liyakeselman/Spinning_Top_Real_Time_Platform/OtherFolders/MediaFiles/Images/Wallpapers/w3.png

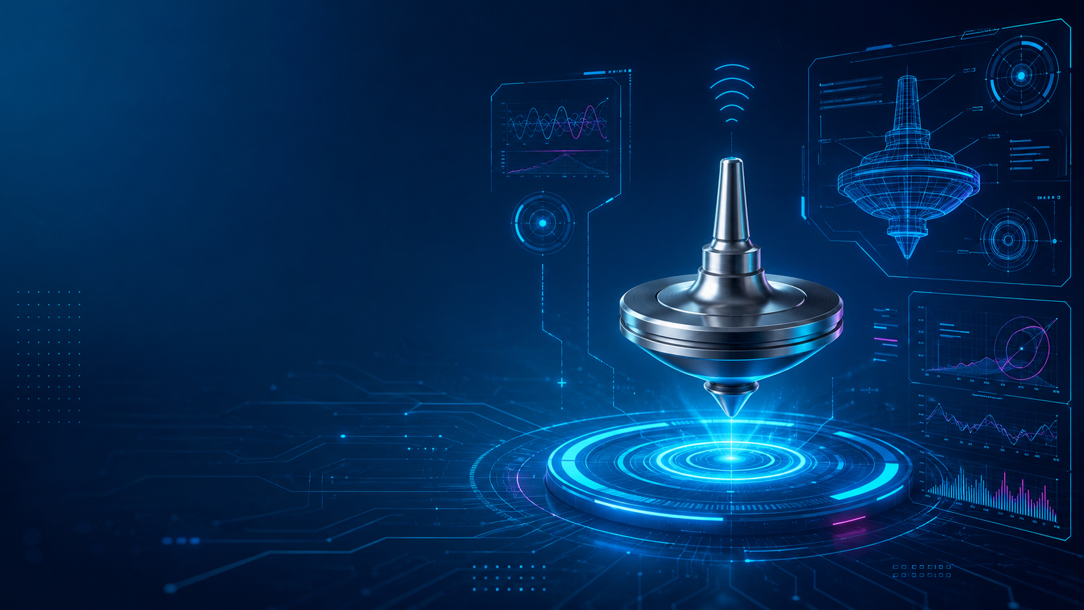
OtherFolders/MediaFiles/Images/Wallpapers/w3.png
