liyakeselman/Spinning_Top_Real_Time_Platform/OtherFolders/MediaFiles/Images/Wallpapers/w1.png

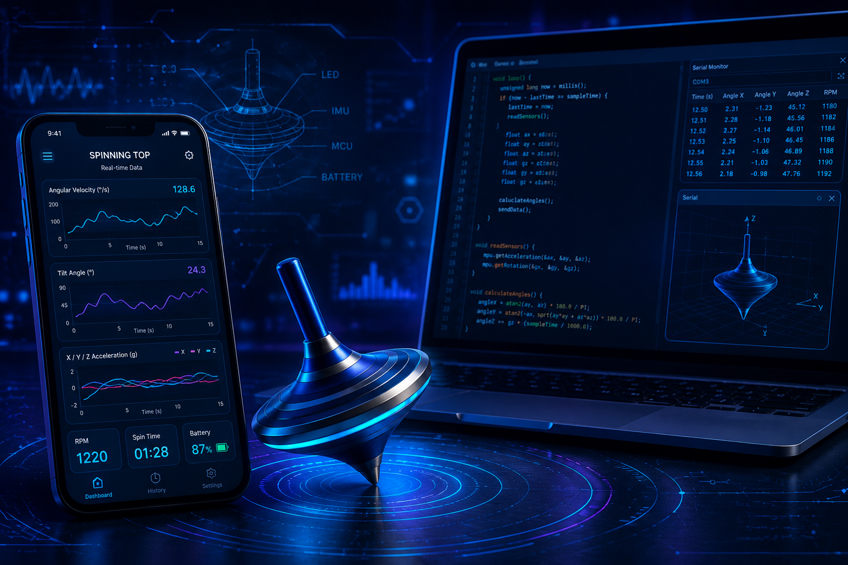
OtherFolders/MediaFiles/Images/Wallpapers/w1.png
