liyakeselman/Spinning_Top_Real_Time_Platform/Data_sh/Readme.txt

Data_sh Directory Content:
(directory) Battery
(directory) Distance_Sensors
(directory) ESP32
(directory) Light_Dependant_Resistor
(directory) Motor_Driver_L9110S
(directory) MPU6050
