liyakeselman/Spinning_Top_Real_Time_Platform/OtherFolders/Readme.txt

OtherFolders Directory Content:
(directory) MediaFiles
(directory) KiCad
(directory) ErrorSheet
(directory) ComponentsList
(directory) BOM
(directory) 3D_PrintFiles
(directory) 3D_Fusion360Files
