liyakeselman/Spinning_Top_Real_Time_Platform/Sch/Readme.txt

Sch Directory Content:
CompositionScheme.pdf
Schematic.pdf
