liyakeselman/Spinning_Top_Real_Time_Platform/OtherFolders/KiCad/Readme.txt

KiCad Directory Content:
(directory) KiCad_ProjA
(directory) KiCad_ProjB
