liyakeselman/Spinning_Top_Real_Time_Platform/OtherFolders/3D_Fusion360Files/ProjectA_3D_Fusion360Files/Readme.txt

ProjectA_3D_Fusion360Files Directory Content:
(directory) BatteryFiles 
(directory) BatteryHolderFiles
(directory) BuckBoostConverterFiles
(directory) DreidelFiles
(directory) ESP32Files
(directory) GeometryFiles
(directory) HammerFiles
(directory) FullModelFiles
(directory) MotorDriverFiles
(directory) MPU6050Files
(directory) ScrewsFiles
(directory) TFLunaFiles
(directory) TP4056Files
(directory) TubeWeightFiles
(directory) VL53L0XV2Files
