liyakeselman/Spinning_Top_Real_Time_Platform/OtherFolders/KiCad/KiCad_ProjA/projectA/production/invoice.pdf

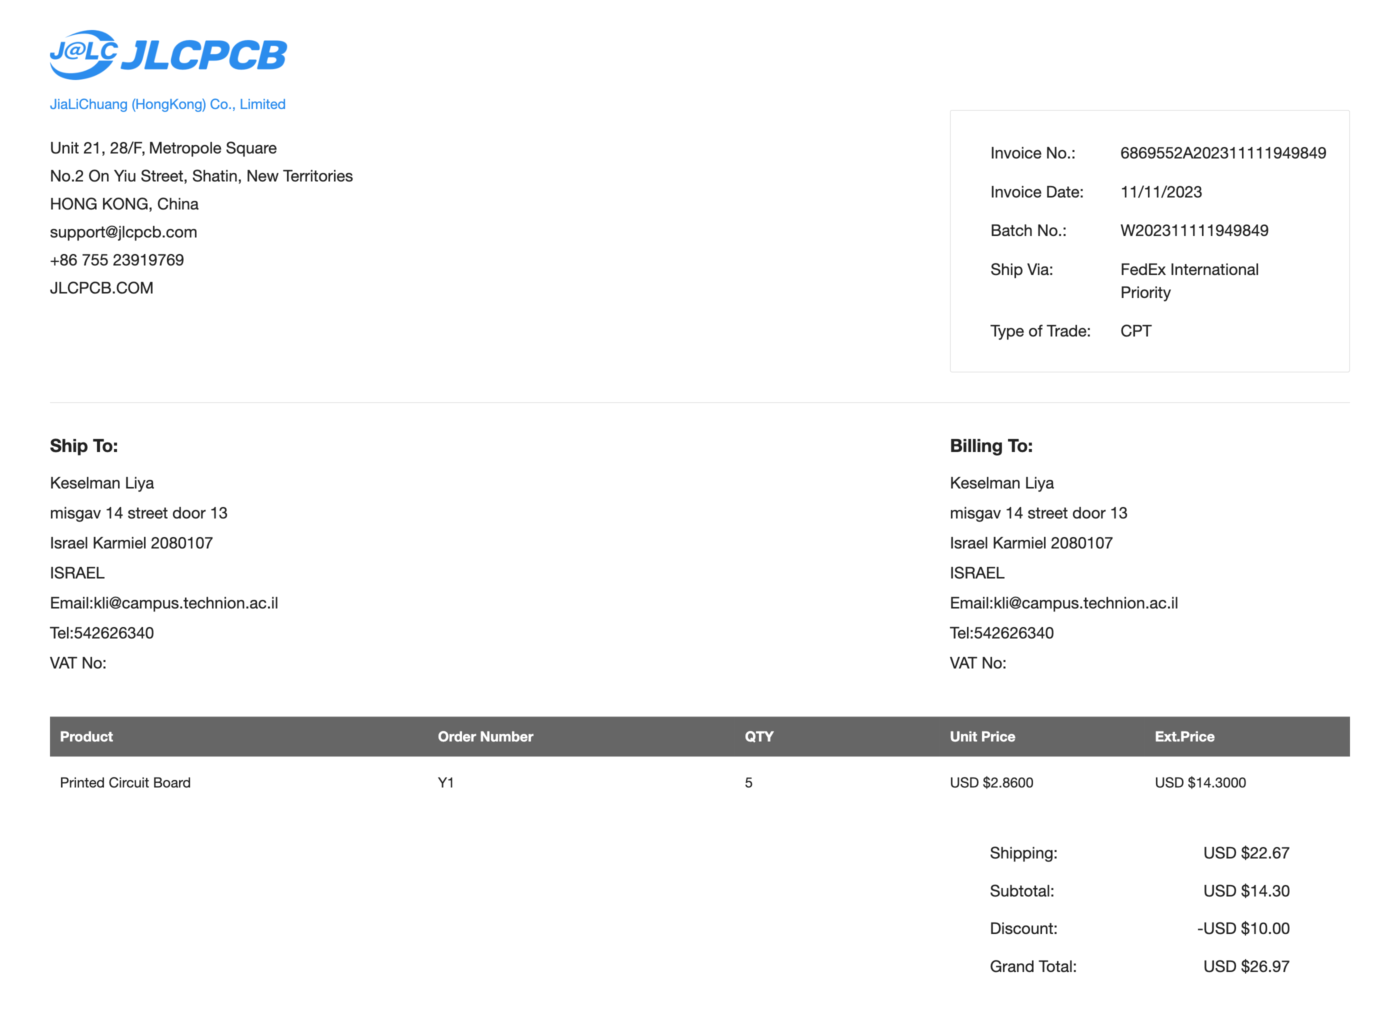
[picture p37: figure]
