liyakeselman/Spinning_Top_Real_Time_Platform/OtherFolders/KiCad/KiCad_ProjA/projectA/production/salesContract.pdf

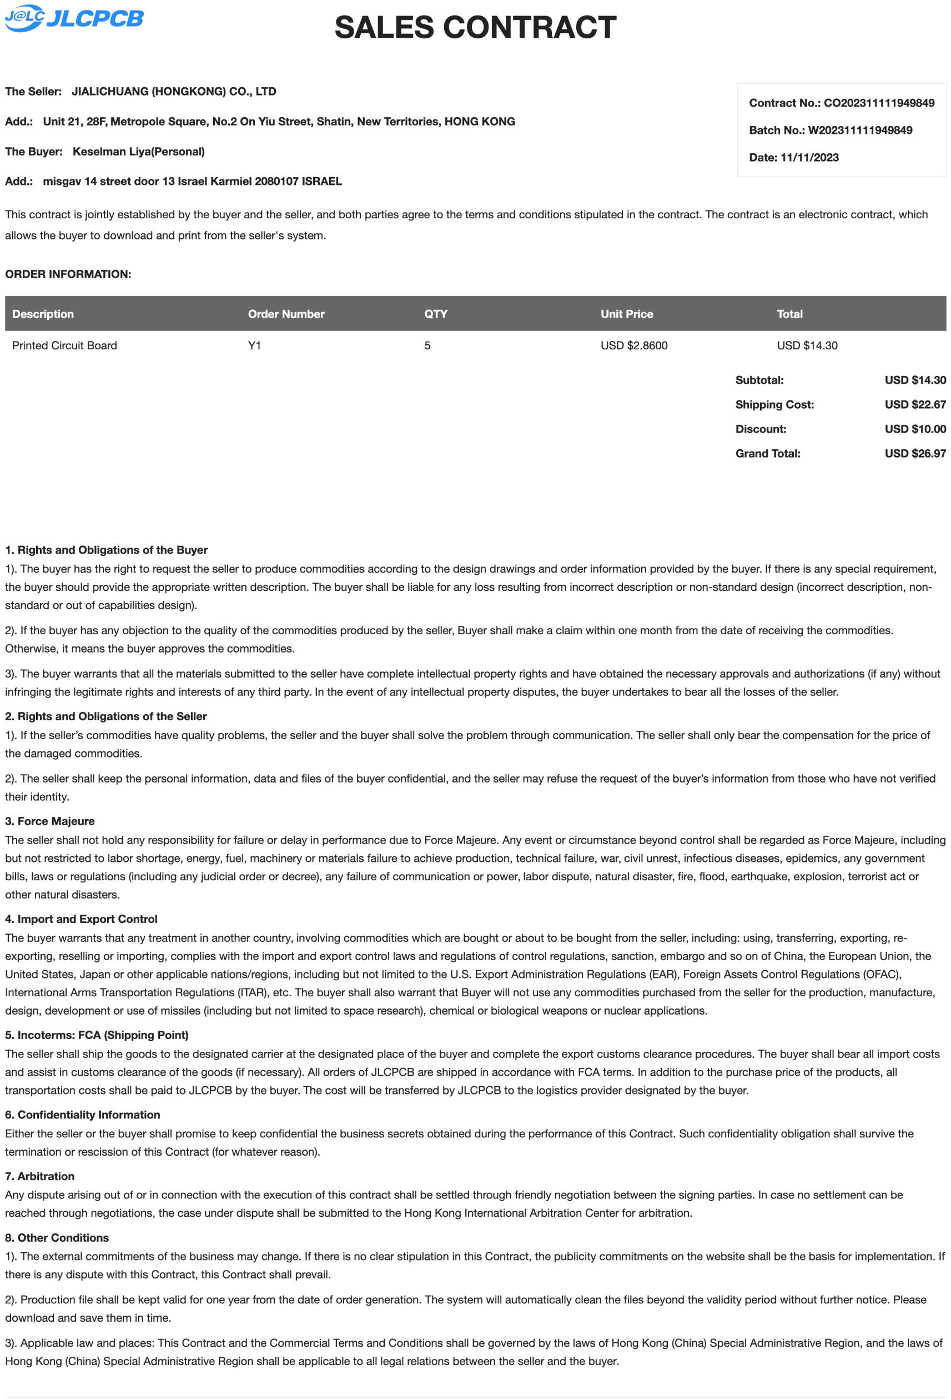
[picture p38: page 1]
