liyakeselman/Spinning_Top_Real_Time_Platform/OtherFolders/3D_Fusion360Files/ProjectA_3D_Fusion360Files/BatteryHolderFiles/lithium-ion-18650-battery-holder-1.snapshot.3/Battery Holder.PNG

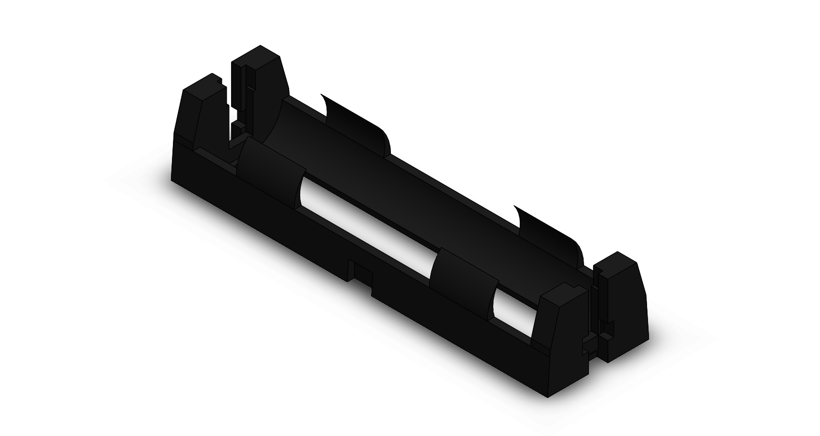
OtherFolders/3D_Fusion360Files/ProjectA_3D_Fusion360Files/BatteryHolderFiles/lithium-ion-18650-battery-holder-1.snapshot.3/Battery Holder.PNG
