liyakeselman/Spinning_Top_Real_Time_Platform/OtherFolders/3D_Fusion360Files/ProjectA_3D_Fusion360Files/BuckBoostConverterFiles/buck_boost.png

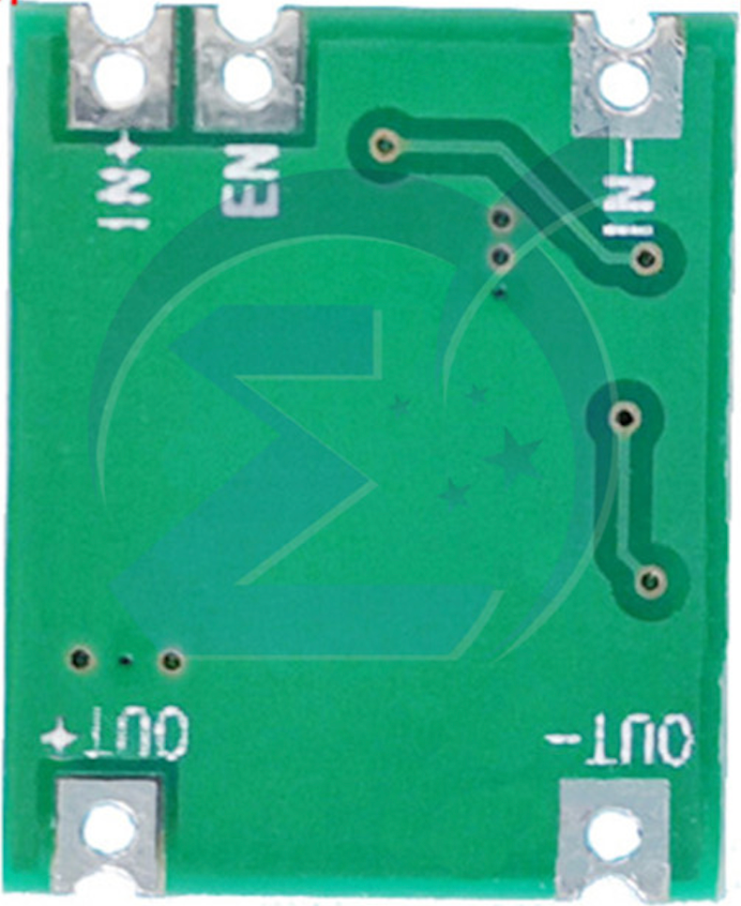
OtherFolders/3D_Fusion360Files/ProjectA_3D_Fusion360Files/BuckBoostConverterFiles/buck_boost.png
