liyakeselman/Spinning_Top_Real_Time_Platform/OtherFolders/3D_Fusion360Files/ProjectA_3D_Fusion360Files/BuckBoostConverterFiles/DC3V-15V-Buck-Boost.jpg_.webp

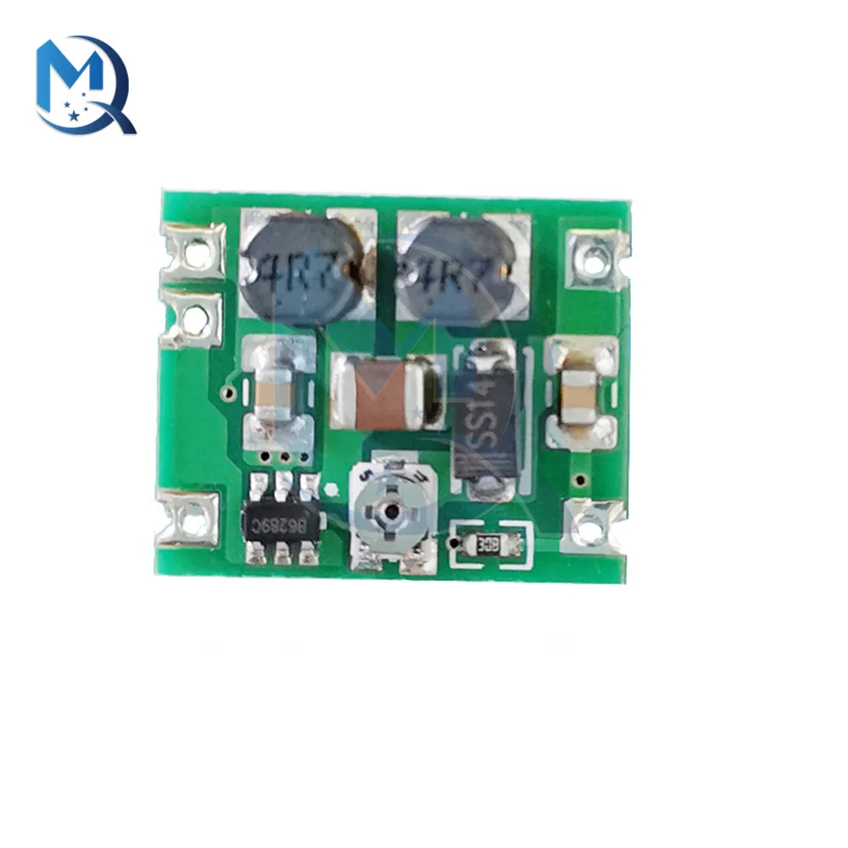
OtherFolders/3D_Fusion360Files/ProjectA_3D_Fusion360Files/BuckBoostConverterFiles/DC3V-15V-Buck-Boost.jpg_.webp
