liyakeselman/Spinning_Top_Real_Time_Platform/OtherFolders/3D_Fusion360Files/ProjectA_3D_Fusion360Files/ESP32Files/option2_goouuu-esp32-development-board-1.snapshot.3/Goouuu-ESP32 Development Board - ISO.JPG

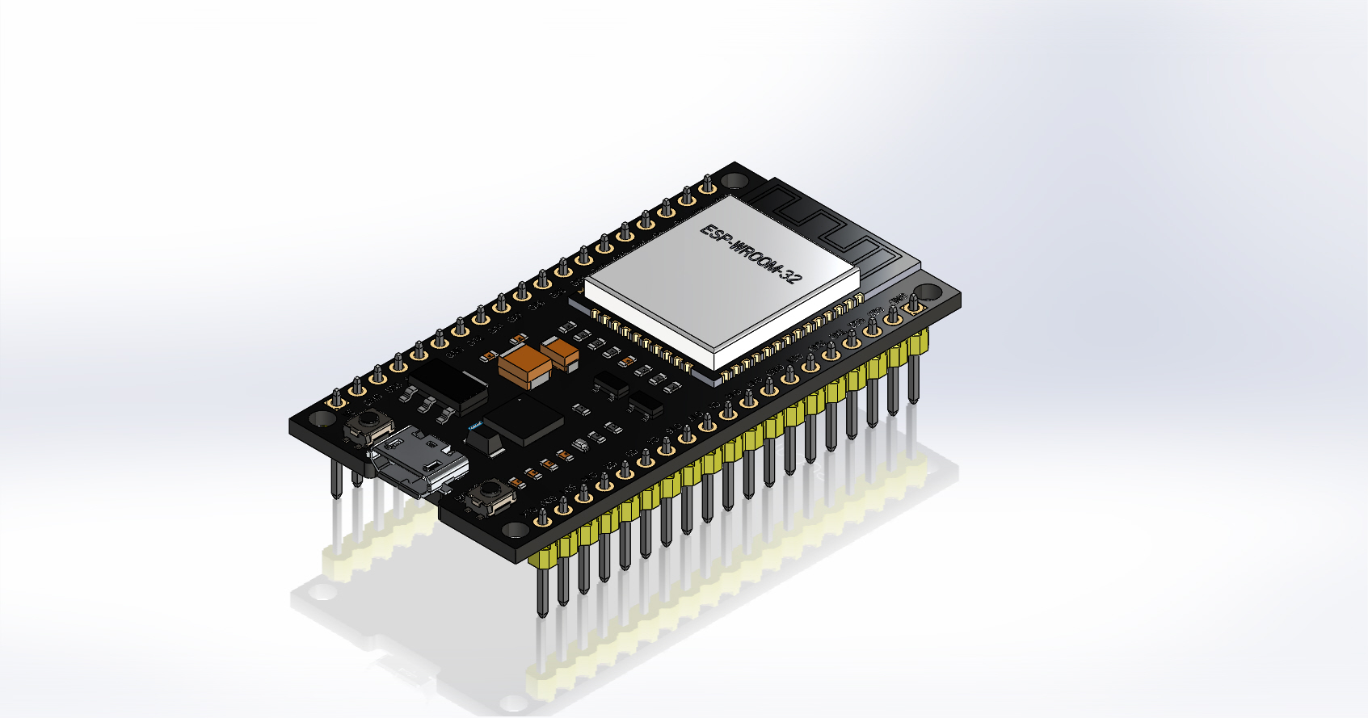
OtherFolders/3D_Fusion360Files/ProjectA_3D_Fusion360Files/ESP32Files/option2_goouuu-esp32-development-board-1.snapshot.3/Goouuu-ESP32 Development Board - ISO.JPG
