liyakeselman/Spinning_Top_Real_Time_Platform/OtherFolders/3D_Fusion360Files/ProjectA_3D_Fusion360Files/TP4056Files/tp4056_option1/微信图片_20210121220738.jpg

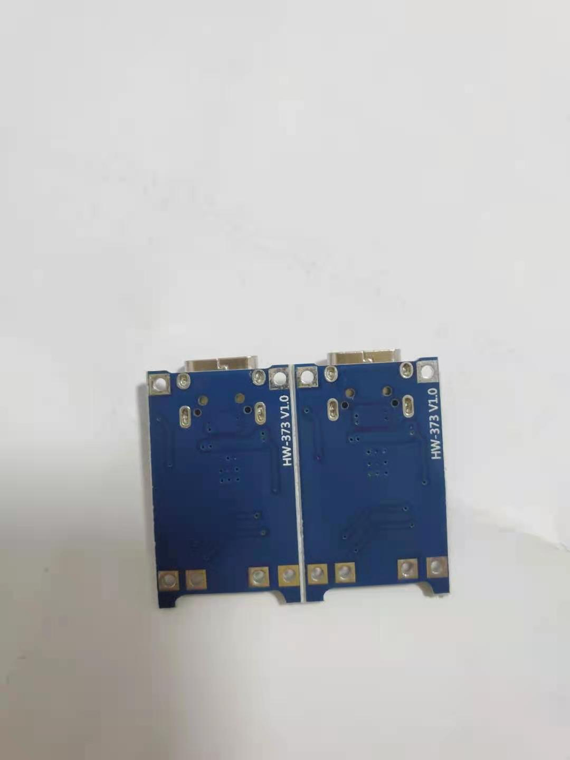
OtherFolders/3D_Fusion360Files/ProjectA_3D_Fusion360Files/TP4056Files/tp4056_option1/微信图片_20210121220738.jpg
