liyakeselman/Spinning_Top_Real_Time_Platform/OtherFolders/MediaFiles/Images/3DModel/3D_1.png

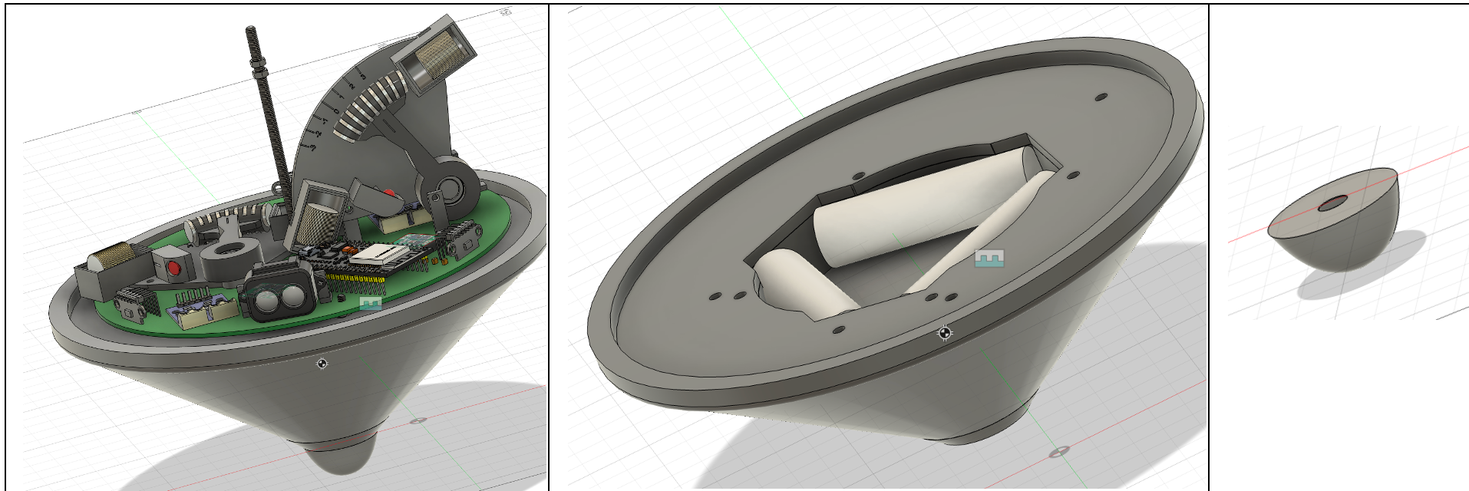
OtherFolders/MediaFiles/Images/3DModel/3D_1.png
