liyakeselman/Spinning_Top_Real_Time_Platform/OtherFolders/MediaFiles/Images/CAM/3dprint.png

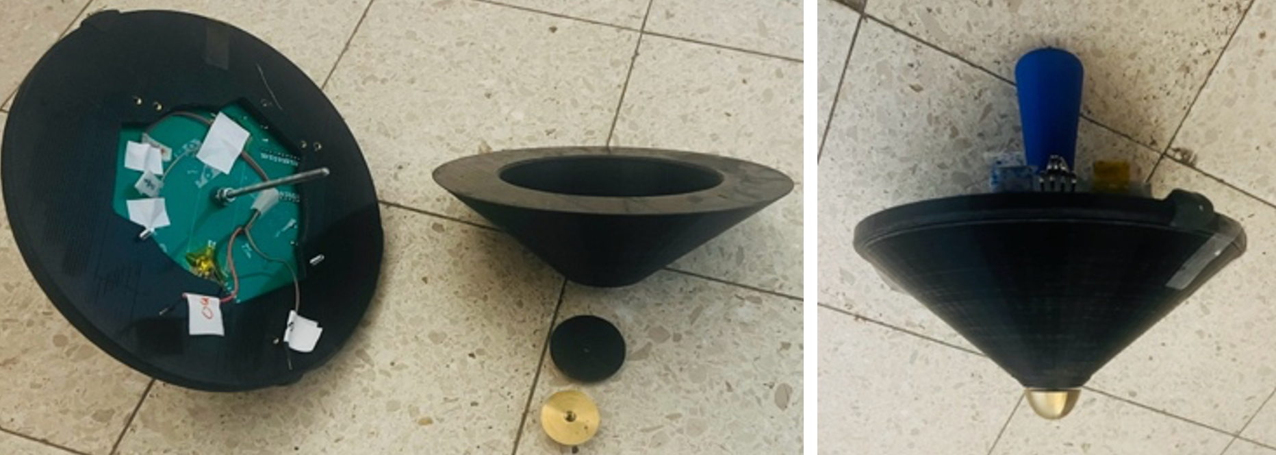
OtherFolders/MediaFiles/Images/CAM/3dprint.png
