liyakeselman/Spinning_Top_Real_Time_Platform/OtherFolders/MediaFiles/Images/CAM/app.png

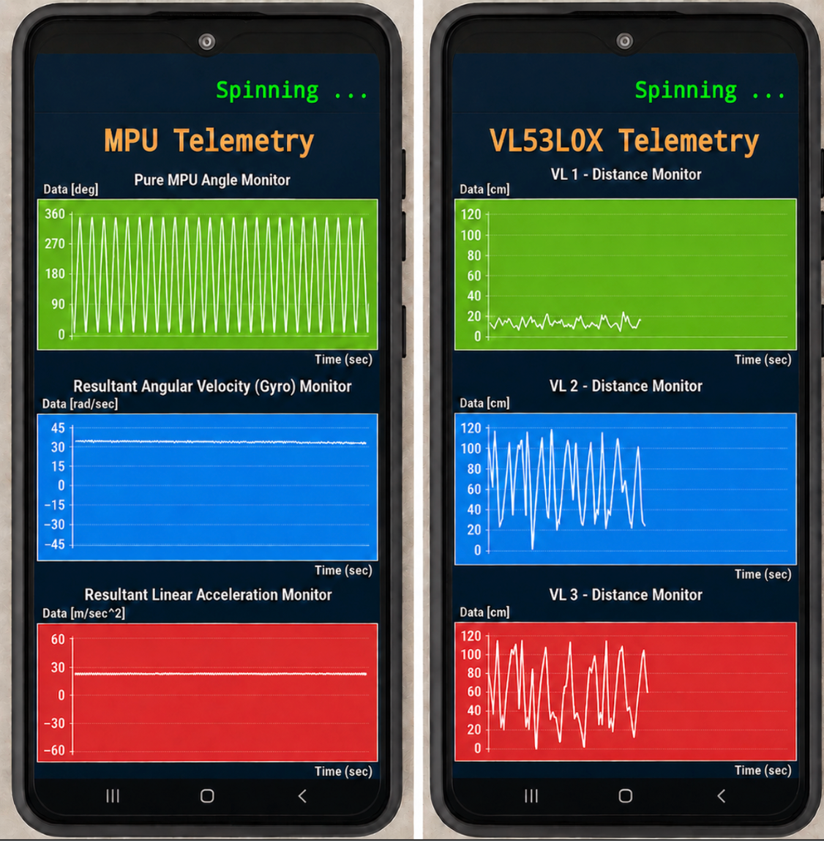
OtherFolders/MediaFiles/Images/CAM/app.png
