liyakeselman/Spinning_Top_Real_Time_Platform/OtherFolders/MediaFiles/Images/CAM/pcb.png

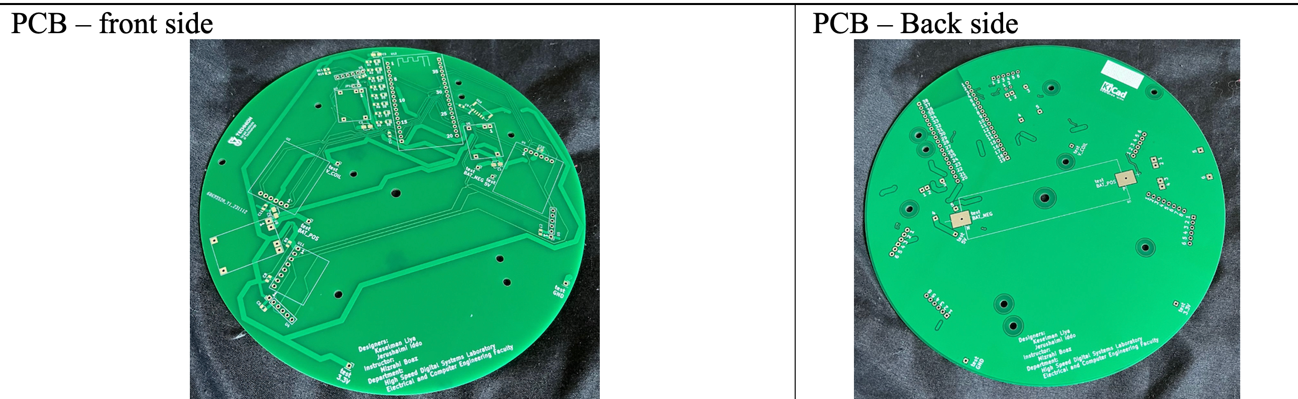
OtherFolders/MediaFiles/Images/CAM/pcb.png
