liyakeselman/Spinning_Top_Real_Time_Platform/OtherFolders/MediaFiles/Images/CAM/spinningtop1.png

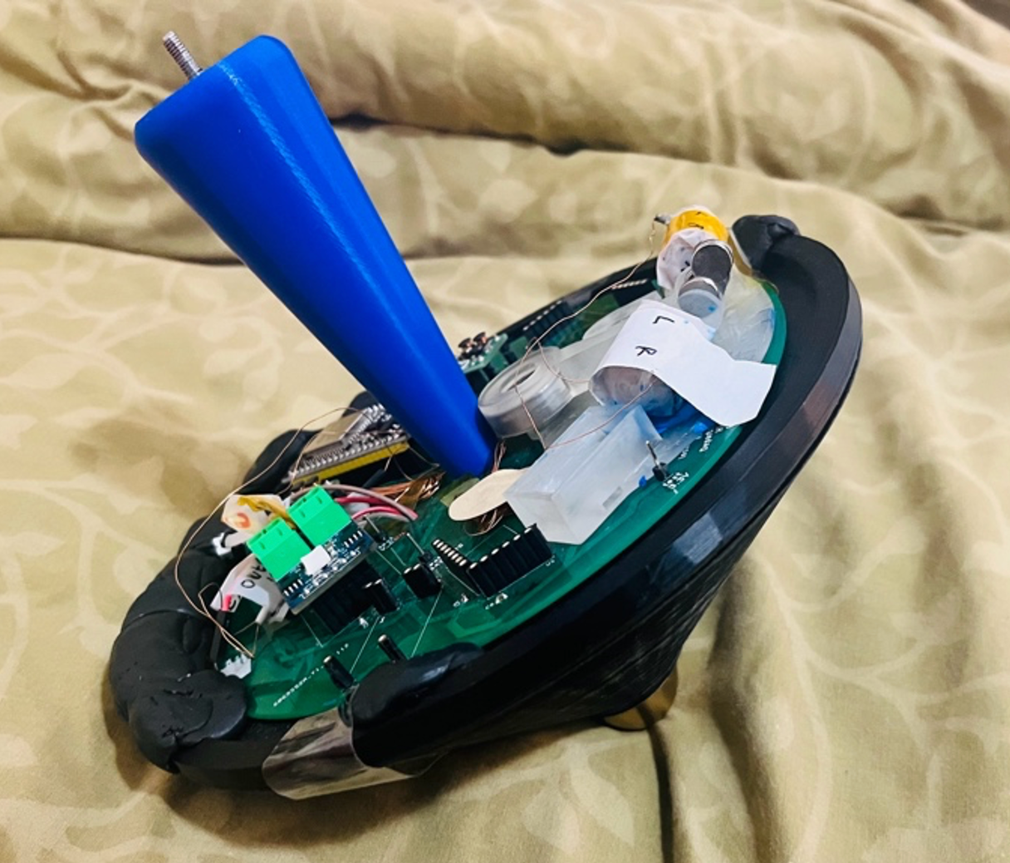
OtherFolders/MediaFiles/Images/CAM/spinningtop1.png
