liyakeselman/Spinning_Top_Real_Time_Platform/OtherFolders/MediaFiles/Images/CAM/spinningtop2.png

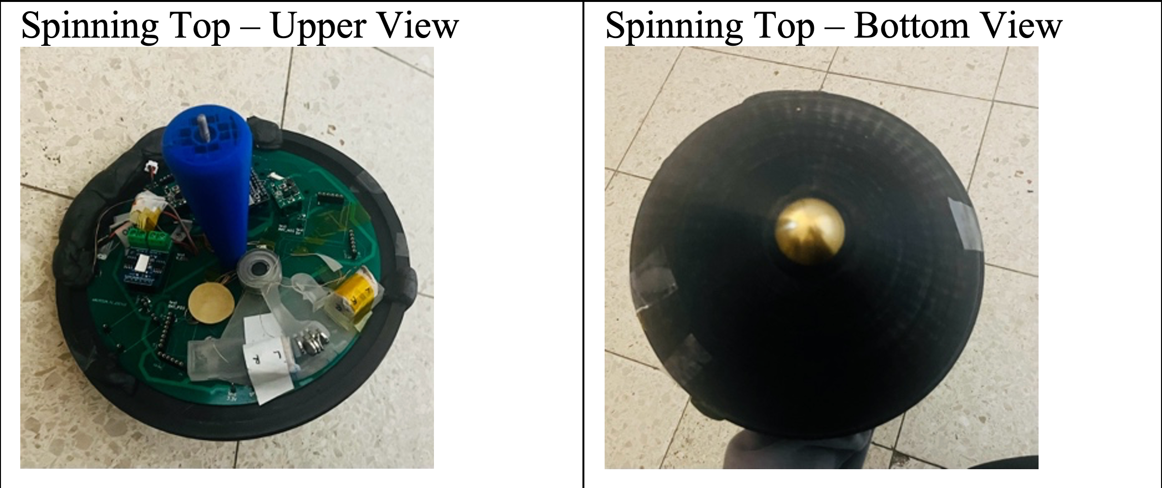
OtherFolders/MediaFiles/Images/CAM/spinningtop2.png
