liyakeselman/Spinning_Top_Real_Time_Platform/OtherFolders/MediaFiles/Images/CAM/spinningtop3.png

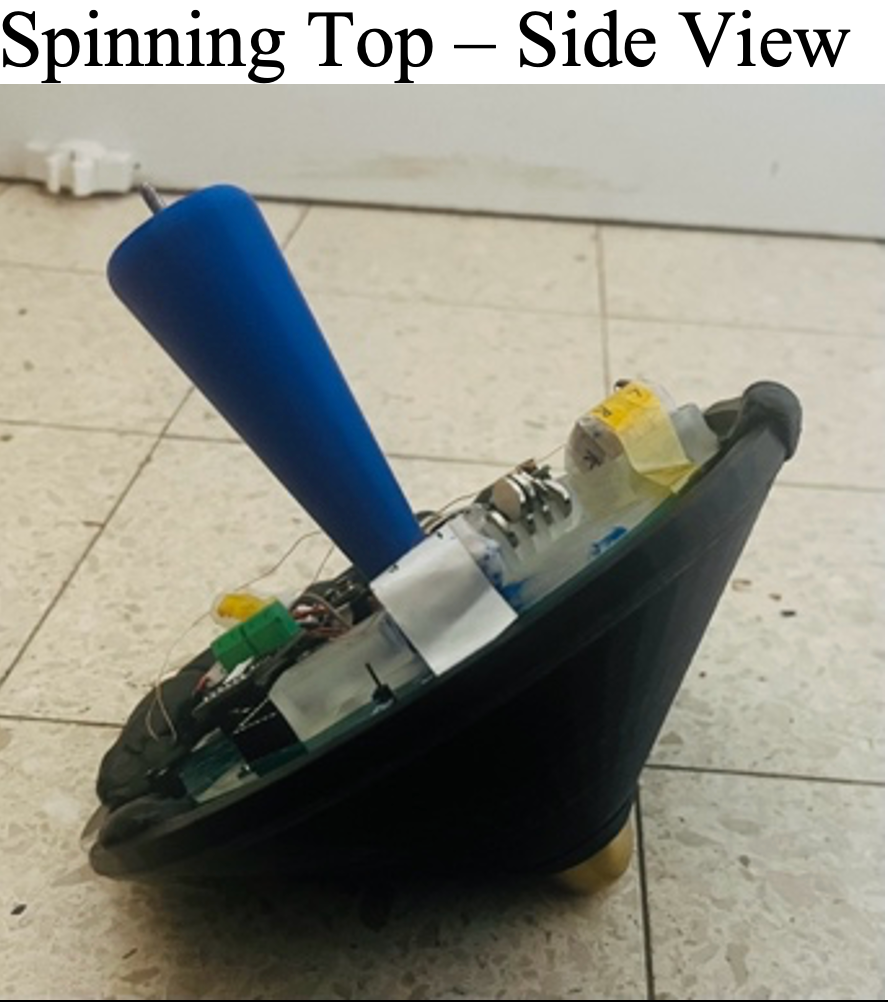
OtherFolders/MediaFiles/Images/CAM/spinningtop3.png
