liyakeselman/Spinning_Top_Real_Time_Platform/OtherFolders/MediaFiles/Images/CAM/stabilization.png

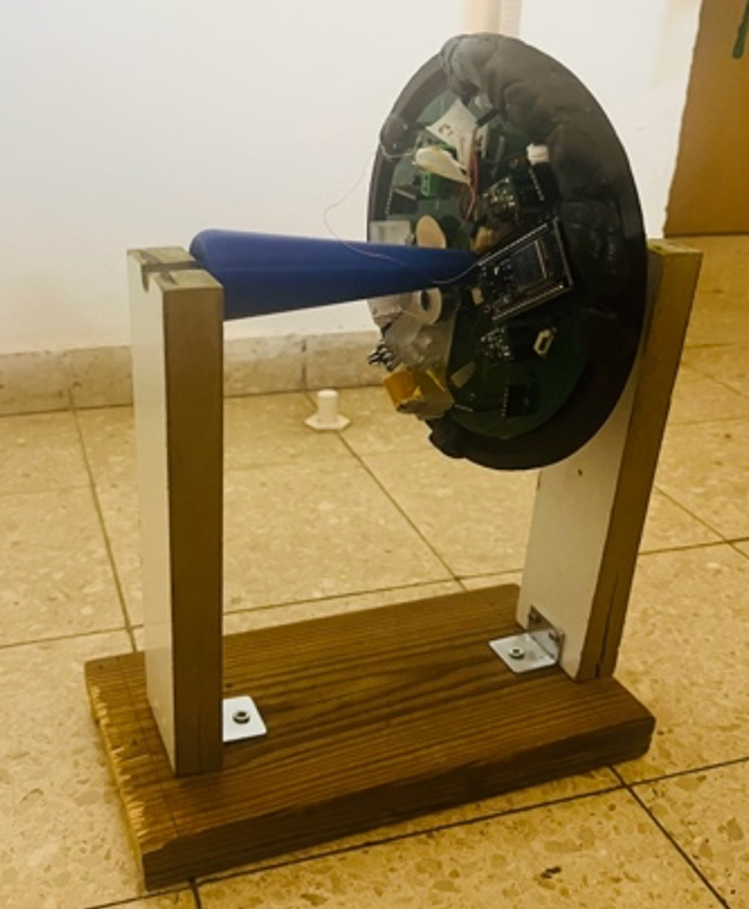
OtherFolders/MediaFiles/Images/CAM/stabilization.png
