liyakeselman/Spinning_Top_Real_Time_Platform/OtherFolders/MediaFiles/Images/diagrams/diagram6.png

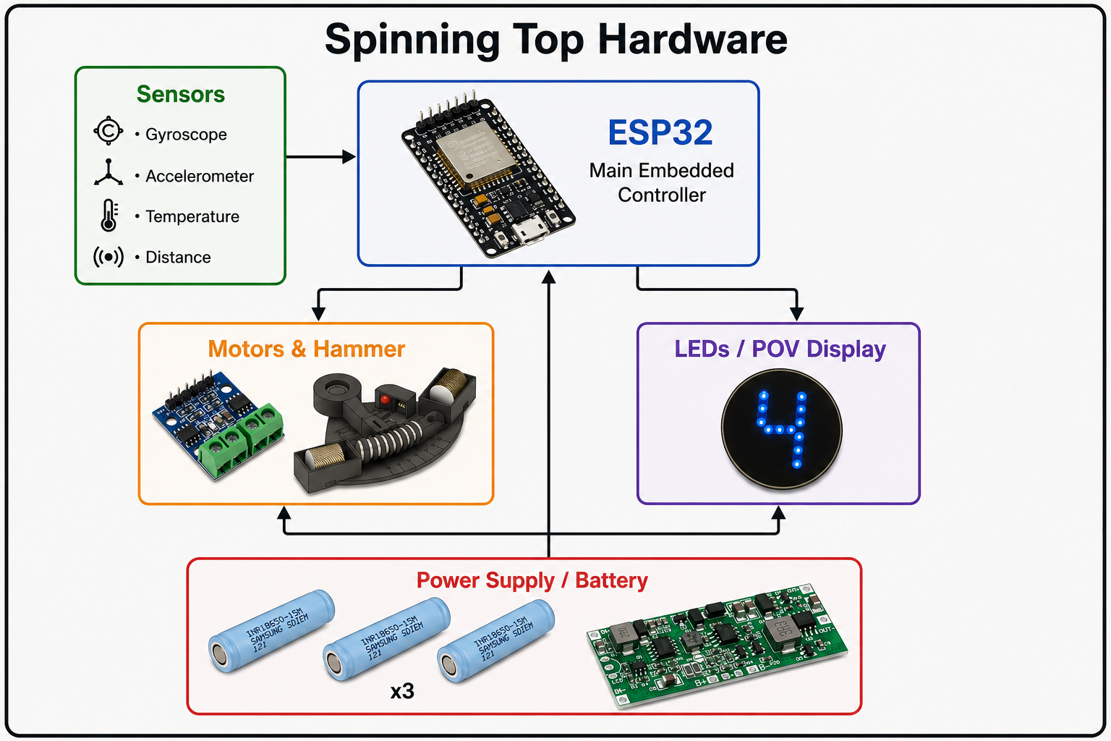
OtherFolders/MediaFiles/Images/diagrams/diagram6.png
