liyakeselman/Spinning_Top_Real_Time_Platform/OtherFolders/MediaFiles/Images/diagrams/diagram10.png

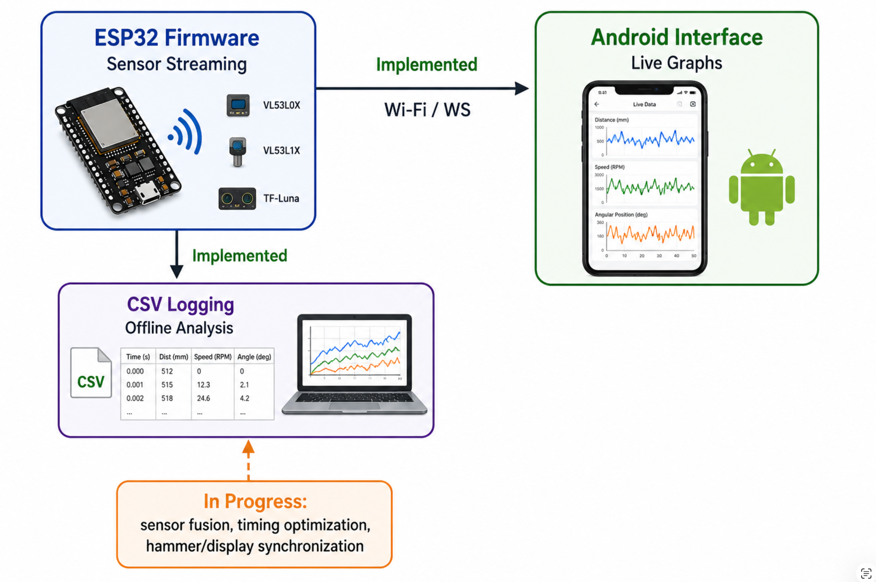
OtherFolders/MediaFiles/Images/diagrams/diagram10.png
