liyakeselman/Spinning_Top_Real_Time_Platform/OtherFolders/MediaFiles/Images/diagrams/diagram13.png

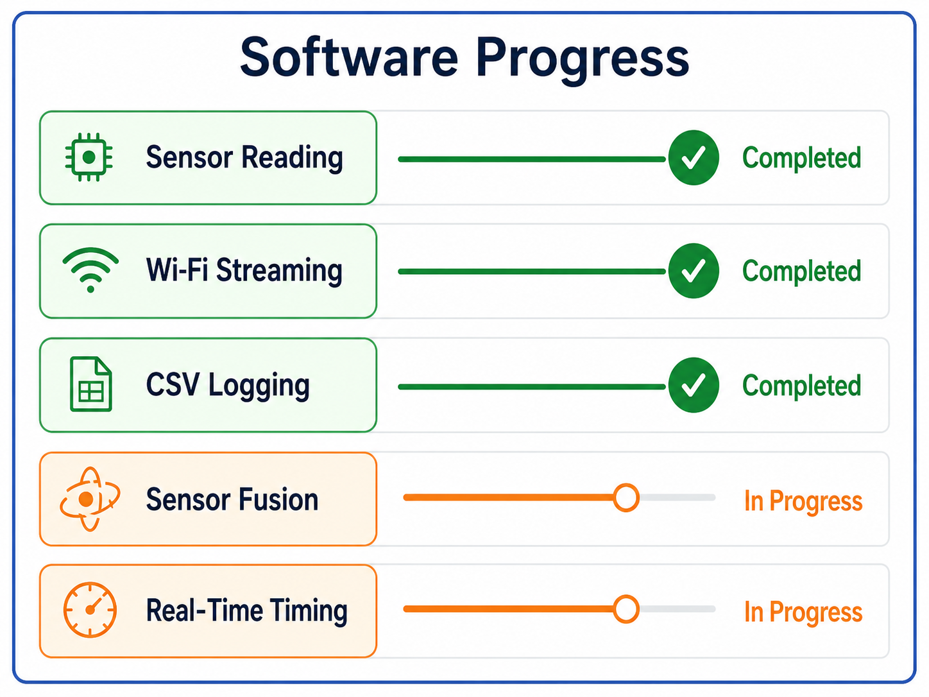
OtherFolders/MediaFiles/Images/diagrams/diagram13.png
