liyakeselman/Spinning_Top_Real_Time_Platform/OtherFolders/MediaFiles/Images/diagrams/diagram23png.png

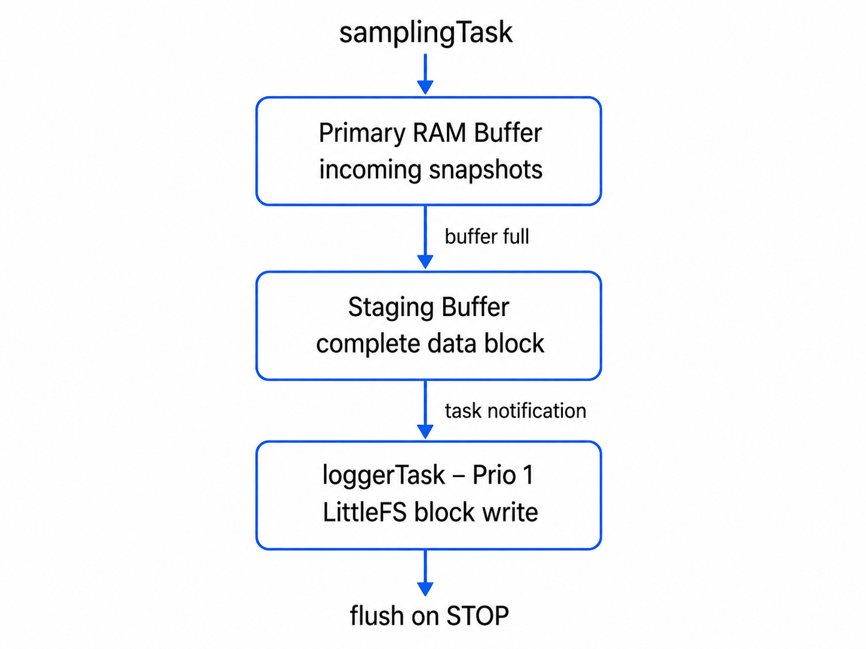
OtherFolders/MediaFiles/Images/diagrams/diagram23png.png
