liyakeselman/Spinning_Top_Real_Time_Platform/OtherFolders/MediaFiles/Images/Wallpapers/w2.png

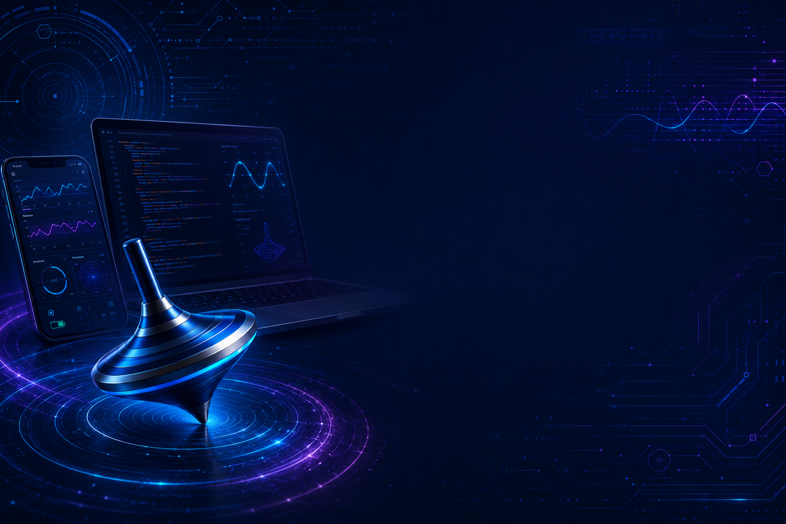
OtherFolders/MediaFiles/Images/Wallpapers/w2.png
