liyakeselman/Spinning_Top_Real_Time_Platform/OtherFolders/MediaFiles/Images/Wallpapers/w4.png

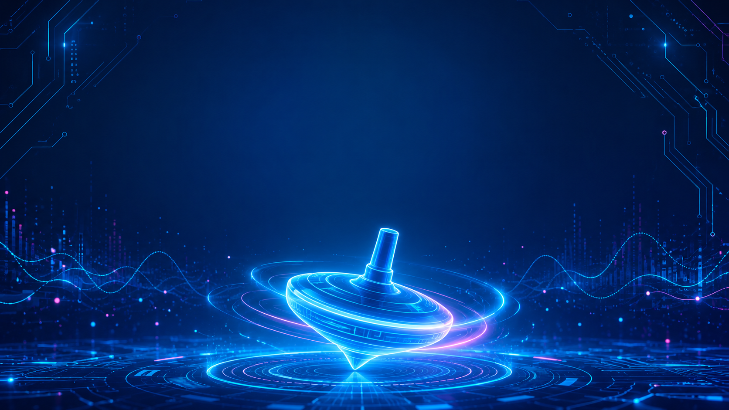
OtherFolders/MediaFiles/Images/Wallpapers/w4.png
