liyakeselman/Spinning_Top_Real_Time_Platform/OtherFolders/ComponentsList/components_list.pdf

טקיורפל םיביכר ב ודיעו היל לש ׳
| | ל רושיק -datasheet היינקל רושיק ביכר םש | תשרדנ תומכ ל2- וביבס םינ | ל רושיק -pinout לודומה לש
vl53l0xv2 distance sensor | link (https://he.aliexpress.com/item/32902676861.html?curPageLogUid=rx7kO7K3YIRo) | link (https://www.st.com/resource/en/datasheet/vl53l0x.pdf) | 6 | link (https://m.media-amazon.com/images/I/71omjIzckuL._SL1500_.jpg)
L9110 S- Channel Motor Driver | link (https://he.aliexpress.com/item/1005005469263941.html?curPageLogUid=7hnDj1nQTp9B) | link (https://www.laskakit.cz/user/related_files/l9110_2_channel_motor_driver.pdf) | 4 | link (https://he.aliexpress.com/item/4000640719200.html?curPageLogUid=mOxAnfovqIoe) link (https://www.utmel.com/components/l9110s-2-channel-motor-driver-circuit-pinout-and-how-to-work-video-faq?id=1988)
DC3V-15V Mini Automatic Buck-Boost Regulator Module Stabilized Power Supply Module DC-DC Automatic Voltage Regulator Board | link (https://he.aliexpress.com/item/1005009401493195.html?curPageLogUid=AawMpAeaVnFY) | aliexpress (https://www.aliexpress.com/item/1005003223925809.html?_t=pvid%3A15417089-c774-4343-b987-dd72966b16d5) | 4 | aliexpress (https://www.aliexpress.com/item/1005003223925809.html?_t=pvid%3A15417089-c774-4343-b987-dd72966b16d5)
1Set IIC I2C GY-521 MPU-6050 MPU6050 3 Axis Analog Gyroscope Sensors + Accelerometer Module For Arduino With Pins 3-5V DC | link (https://he.aliexpress.com/item/1005008604349573.html?curPageLogUid=zbkrNPWYP7Ae) | link (https://invensense.tdk.com/wp-content/uploads/2015/02/MPU-6000-Datasheet1.pdf) | 2 | link (https://components101.com/sensors/mpu6050-module)
Goouuu-ESP32 Development Board WiFi+Bluetooth Ultra-Low Power Consumption Dual Cores ESP-32 ESP-32S Board for arduino | link (https://he.aliexpress.com/item/1005010243973125.html?curPageLogUid=Hic9dPfUTtZG) | module_link (https://www.espressif.com/sites/default/files/documentation/esp32-wroom-32d_esp32-wroom-32u_datasheet_en.pdf) | 2 | link (https://www.upesy.com/blogs/tutorials/esp32-pinout-reference-gpio-pins-ultimate-guide)
Tf luna distance sensor | link (https://www.aliexpress.com/item/1005001552425264.html?curPageLogUid=FELvBh8KFW2E) | link (https://files.seeedstudio.com/wiki/Grove-TF_Mini_LiDAR/res/SJ-PM-TF-Luna-A03-Product-Manual.pdf) | 2 | link (https://files.seeedstudio.com/wiki/Grove-TF_Mini_LiDAR/res/SJ-PM-TF-Luna-A03-Product-Manual.pdf) page 11
1~50PCS 3S 12V 3A 24W 36W Lithium Battery UPS Module Charging Discharging Automatic Switching Uninterruptible Power Supply Board | link (https://he.aliexpress.com/item/1005008051293682.html?gatewayAdapt=glo2isr#nav-moretolove) | | 2
SMD LED 0805 | link (https://www.aliexpress.com/item/1005003631988791.html?curPageLogUid=8EKaaGel4awc) | link (https://www.mouser.com/datasheet/2/143/17-21-BHC-AP1Q2-3T_datasheet-51933.pdf) | 16
10pcs 18650 Battery Holder Box 1 Slot 3.7V-4.2V DIY Battery Storage Case Plastic Container With Connect Black Red Wire Lead Pin | link (https://he.aliexpress.com/item/1005010766462089.html?srcSns=sns_Copy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) | | 6 | -
li-ion 18650 battery | link (https://he.aliexpress.com/item/1005008820100331.html?curPageLogUid=Ehe2A7nnAwLi) | | 6
1.25 mm Connector Vertical SMD Type Male JST Socket Connector 6 pins | link (https://he.aliexpress.com/item/1005007393031874.html?curPageLogUid=ZTtC0QtajIXV) | | 2

םיגרב
תומכ דעוימ ביכר הזיאל גרוב גוס 2 בוביסל תישאר תידי mm100 4m 4 חולה לע םינושיטפה לש תוידי mm8 3m 4 םינושיטפה לע םינושיטפה לש תוידי mm8 3m 4 ה לש תוידי -luna tf חולה לע mm8 3m 4 ה לש תוידי -luna tf ןשייחה לע mm8 2m

םיביכרל הבקנ ירוטקנוק
| דעוימ ביכר הזיאל רפסמ / גוס רוטקנוק חולה לע | תומכ תחקל הדבעמהמ
100mil 19 pin female x 2 | ESP32 | 2
5 pins female | BUCK BOOST | 4
100mil 8 pin female | MPU6050 | 2
100mil 6 pin female | MOTOR DRIVER | 4
100mil 6 pin female | VL53L0XV2 | 6
6 pins female | CHARGE CONTROLLER | 2

םילבק
| | | הדבעמהמ תחקל ריחמ היינקל רושיק תומכ גוס לוביק
10uF | Capacitor_SMD:C_0805_2012Metric | 8 | 40
47uF | Capacitor_SMD:CP_Elec_3x5.3 | 4 | 20

םידגנ
| | | הדבעמהמ תחקל ריחמ היינקל רושיק תומכ גוס תודגנתה
300Ω | Resistor_SMD:R_0805_2012Metric | 8 | 40
3.3kΩ | Resistor_SMD:R_0805_2012Metric | 2 | 10
3.3kΩ | Resistor_SMD:R_0805_2012Metric | 16
- םא ןיא לדוגב ביכר זא הדבעמב 0805 ב דמועש 16- טלוו
ןושיטפה תא םיביכרמה םיביכר
| | | הדבעמהמ תחקל ריחמ היינקל רושיק תומכ גוס
Solenoid Wire Diameter 0.25mm, length 250m | | link (https://he.aliexpress.com/item/4001159051676.html?curPageLogUid=7GCvEto1joOM) 2 × 2 םילילס
Soft iron core Diameter 12.7 mm, length 40mm | | link (https://he.aliexpress.com/item/1005003315397550.html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) 2 × 2 הביל םילילסל
Led light bulb Working voltage of 3.5-4v, illumination 2lum | 2 × 2 | link (https://he.aliexpress.com/item/1005003483614644.html?curPageLogUid=2cXizcPojF9q) | V
Magnets Neodymium magnets, specific gravity of 7.3-7.5 gr/cm^3 | 2 × 2 | link (https://he.aliexpress.com/item/1005003324594101.html?curPageLogUid=S1967SouTyy1)
Photoresistor Light dependent resistor (LDR): 100 Ohm-1MOhm | 1 × 2 | link (https://he.aliexpress.com/item/1005004041212234.html?curPageLogUid=DoSZnhYhpTc0) | V
| | link (https://www.skf.com/group/products/rolling-bearings/ball-bearings/deep-groove-ball-bearings/productid-608) 2 × 1 בסימ

ל ךירצש םיביכר םוסרכ תנוכמ /סיפדה
| | | הנומת היגולונכט תומכ ביכר
| | RESIN 2 ל סיסב -PCB

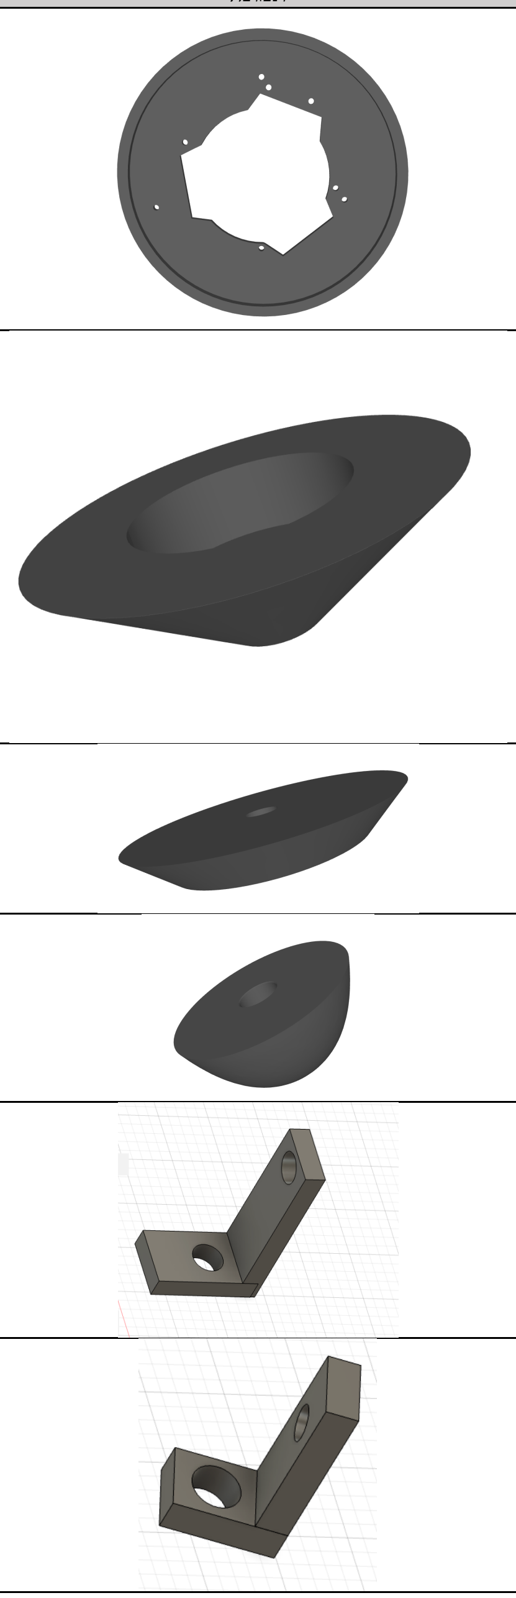
[picture p91: figure]

| | RESIN 2 ק סונו
| | RESIN 2 סונוקל תיתחת
tip | 2 | CNC זילפ (BRASS)
ל( ידיתע חותיפ ) | | RESIN 2 ןושיטפל תידי דמועה
tf-luna- תידי ל | 2 | RESIN

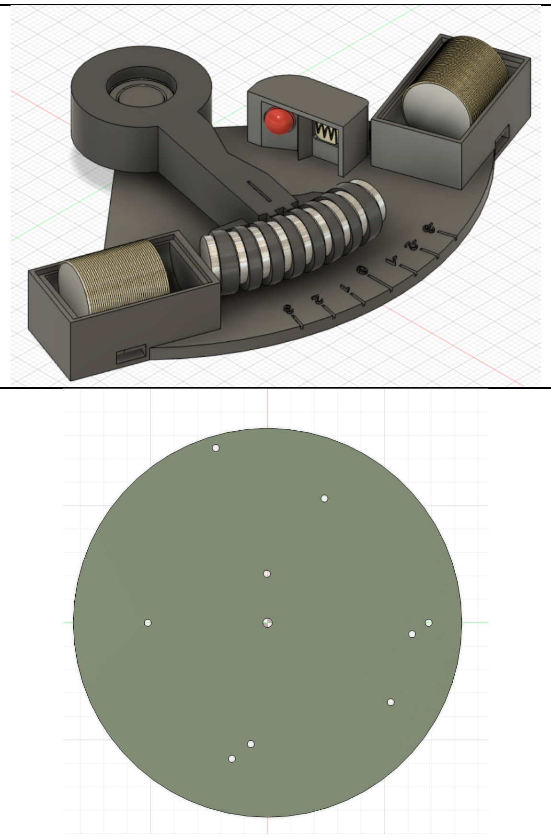
[picture p92: figure]

Hammer | 2 | RESIN
PCB 166 cm diameter, 1.6mm thickness | 2
