liyakeselman/Spinning_Top_Real_Time_Platform/OtherFolders/ComponentsList/Readme.txt

ComponentsList Directory Content:
components_list.pdf
