liyakeselman/Spinning_Top_Real_Time_Platform/OtherFolders/3D_Fusion360Files/ProjectA_3D_Fusion360Files/BatteryHolderFiles/Hold_18650-1p_smd.stp

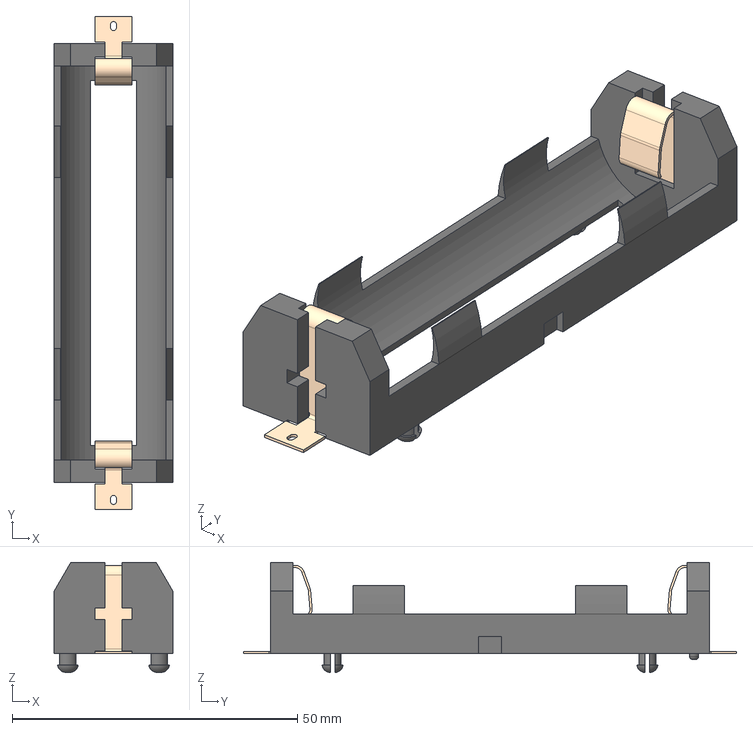
[picture p94: CAD file, 2026-06-14]
OtherFolders/3D_Fusion360Files/ProjectA_3D_Fusion360Files/BatteryHolderFiles/Hold_18650-1p_smd.stp
20.8 x 86.4 x 19.3 mm
