liyakeselman/Spinning_Top_Real_Time_Platform/OtherFolders/3D_Fusion360Files/ProjectA_3D_Fusion360Files/BatteryHolderFiles/lithium-ion-18650-battery-holder-1.snapshot.3/Battery Holder.STEP

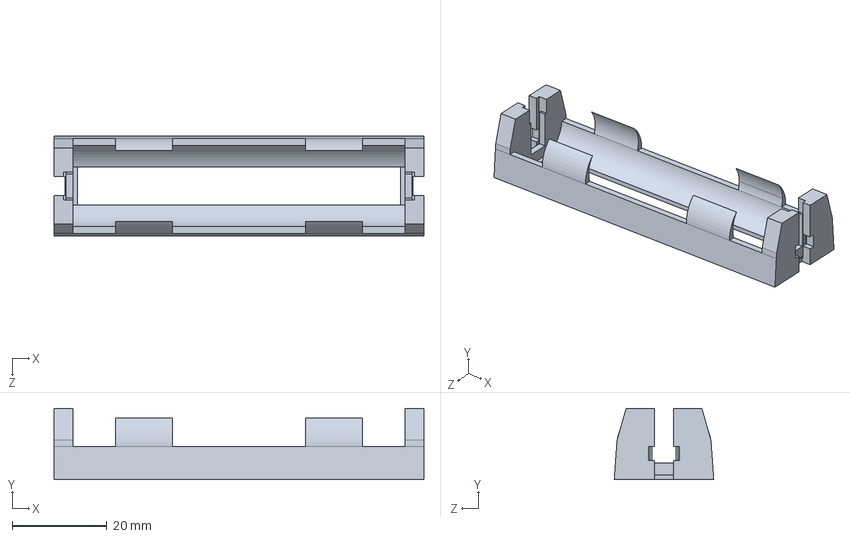
[picture p95: CAD file, 2026-06-14]
OtherFolders/3D_Fusion360Files/ProjectA_3D_Fusion360Files/BatteryHolderFiles/lithium-ion-18650-battery-holder-1.snapshot.3/Battery Holder.STEP
78.0 x 15.0 x 21.0 mm
