liyakeselman/Spinning_Top_Real_Time_Platform/OtherFolders/3D_Fusion360Files/ProjectA_3D_Fusion360Files/GeometryFiles/geometry_front.dxf

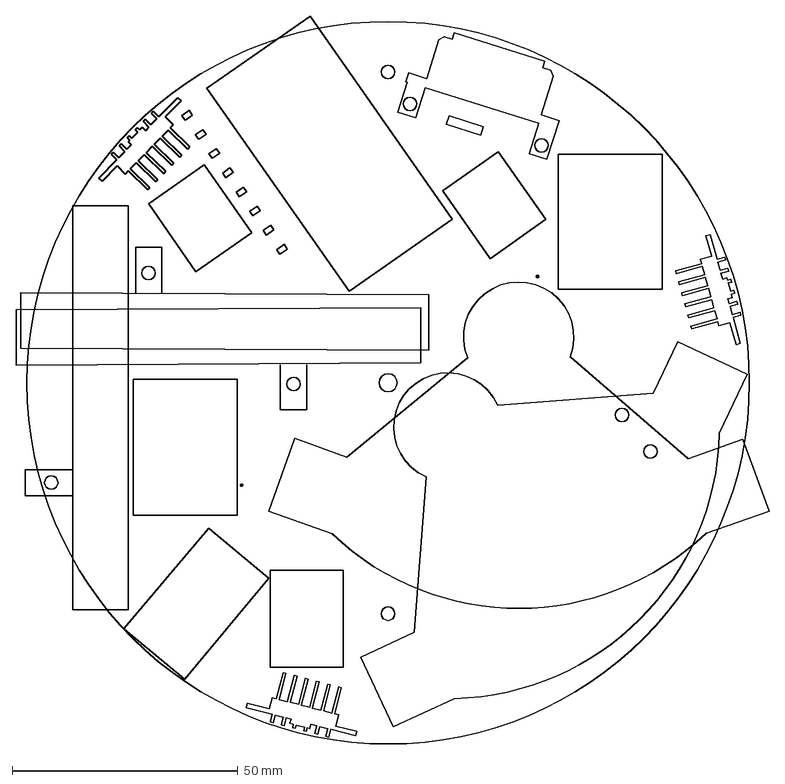
[picture p96: CAD file, 2026-06-14]
OtherFolders/3D_Fusion360Files/ProjectA_3D_Fusion360Files/GeometryFiles/geometry_front.dxf
166.8 x 161.2 mm
