liyakeselman/Spinning_Top_Real_Time_Platform/OtherFolders/3D_Fusion360Files/ProjectA_3D_Fusion360Files/MotorDriverFiles/motor_driver_2.step

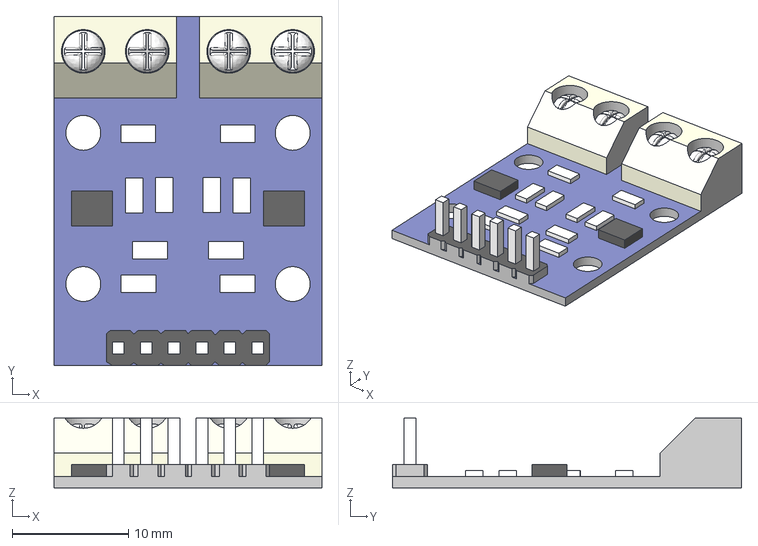
[picture p97: CAD file, 2026-06-14]
OtherFolders/3D_Fusion360Files/ProjectA_3D_Fusion360Files/MotorDriverFiles/motor_driver_2.step
23.0 x 30.0 x 6.00 mm
