liyakeselman/Spinning_Top_Real_Time_Platform/OtherFolders/3D_Fusion360Files/ProjectA_3D_Fusion360Files/MPU6050Files/mpu6050_option1/MPU6050.stp

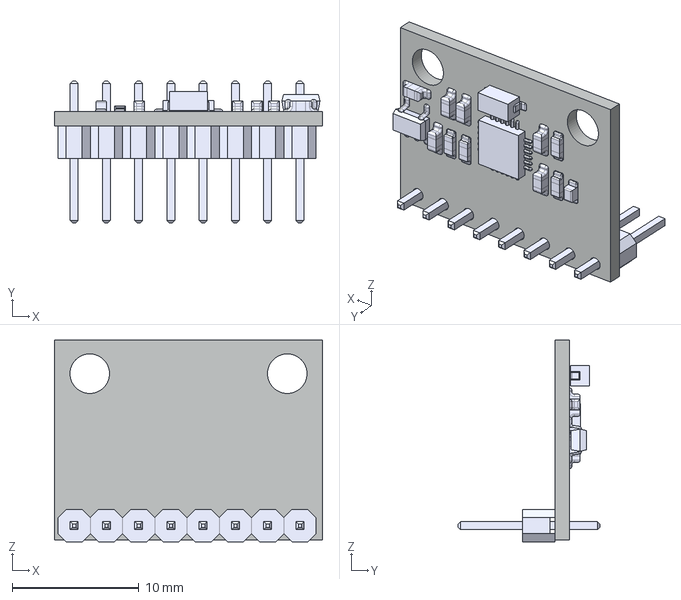
[picture p98: CAD file, 2026-06-14]
OtherFolders/3D_Fusion360Files/ProjectA_3D_Fusion360Files/MPU6050Files/mpu6050_option1/MPU6050.stp
21.1 x 11.2 x 15.9 mm
