liyakeselman/Spinning_Top_Real_Time_Platform/OtherFolders/3D_Fusion360Files/ProjectA_3D_Fusion360Files/MPU6050Files/mpu6050_option2_female_header/MPU-6050-on-female-header.step

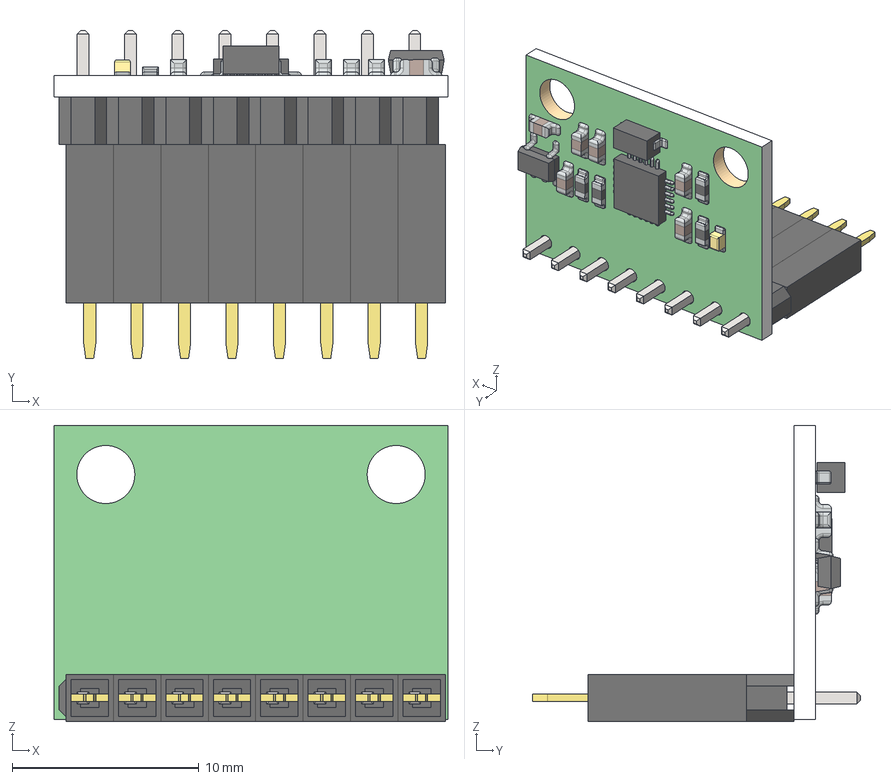
[picture p99: CAD file, 2026-06-14]
OtherFolders/3D_Fusion360Files/ProjectA_3D_Fusion360Files/MPU6050Files/mpu6050_option2_female_header/MPU-6050-on-female-header.step
21.1 x 17.6 x 15.9 mm
Base
pin header x 8
sensor chip
S2NH chip
Resistor small x 6
Resistor small black x 4
Small LED
Resistor black
SIL_Socket_Body x 8
SIL_SocketPin x 8
