liyakeselman/Spinning_Top_Real_Time_Platform/OtherFolders/3D_Fusion360Files/ProjectA_3D_Fusion360Files/TFLunaFiles/benewake-tf-luna-8m-low-cost-distance-sensor-1.snapshot.1/Sensor LUNA.STEP

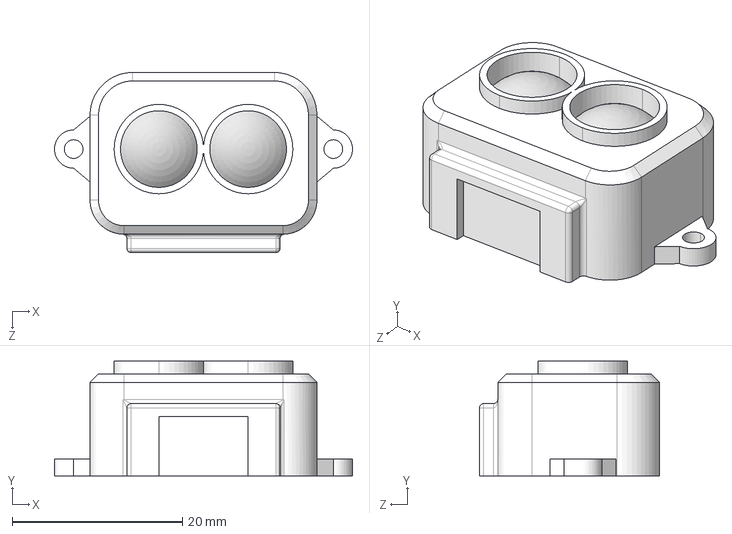
[picture p100: CAD file, 2026-06-14]
OtherFolders/3D_Fusion360Files/ProjectA_3D_Fusion360Files/TFLunaFiles/benewake-tf-luna-8m-low-cost-distance-sensor-1.snapshot.1/Sensor LUNA.STEP
35.0 x 13.5 x 21.2 mm
