liyakeselman/Spinning_Top_Real_Time_Platform/OtherFolders/3D_Fusion360Files/ProjectA_3D_Fusion360Files/VL53L0XV2Files/vl53l0x_PCB.SLDPRT

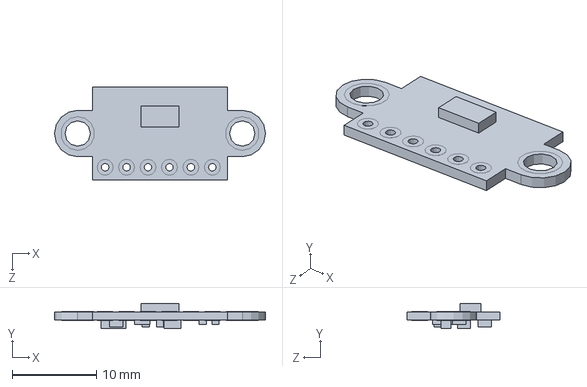
[picture p101: CAD file, 2026-06-14]
OtherFolders/3D_Fusion360Files/ProjectA_3D_Fusion360Files/VL53L0XV2Files/vl53l0x_PCB.SLDPRT
25.0 x 3.00 x 11.0 mm
