liyakeselman/Spinning_Top_Real_Time_Platform/OtherFolders/3D_PrintFiles/ProjectA_3D_PrintFiles/additionalFiles/lone_hammer.step

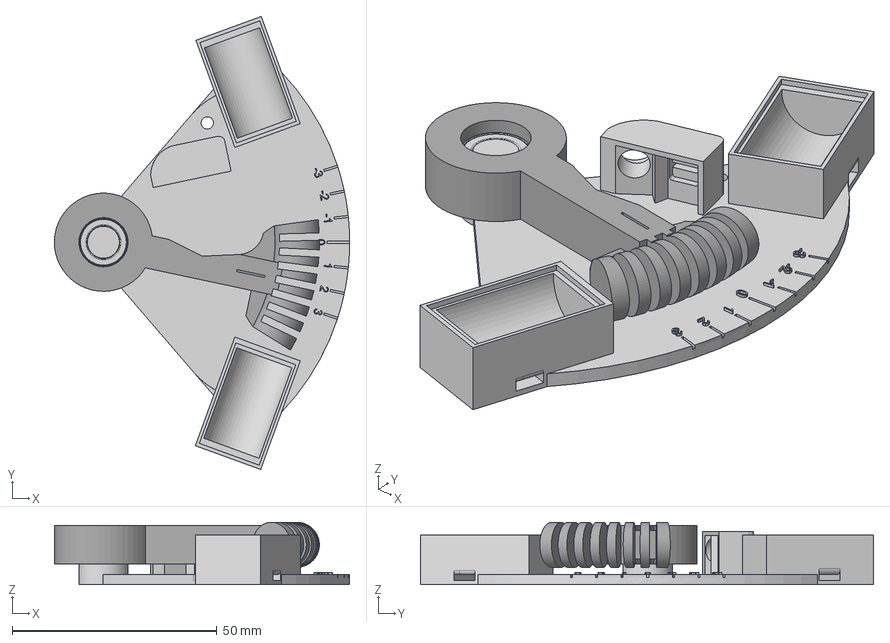
[picture p102: CAD file, 2026-06-14]
OtherFolders/3D_PrintFiles/ProjectA_3D_PrintFiles/additionalFiles/lone_hammer.step
72.1 x 110.6 x 15.2 mm
Ball Bearing
22mm hammer (3)
