liyakeselman/Spinning_Top_Real_Time_Platform/OtherFolders/3D_PrintFiles/ProjectA_3D_PrintFiles/hammer_handle_to_print.stl

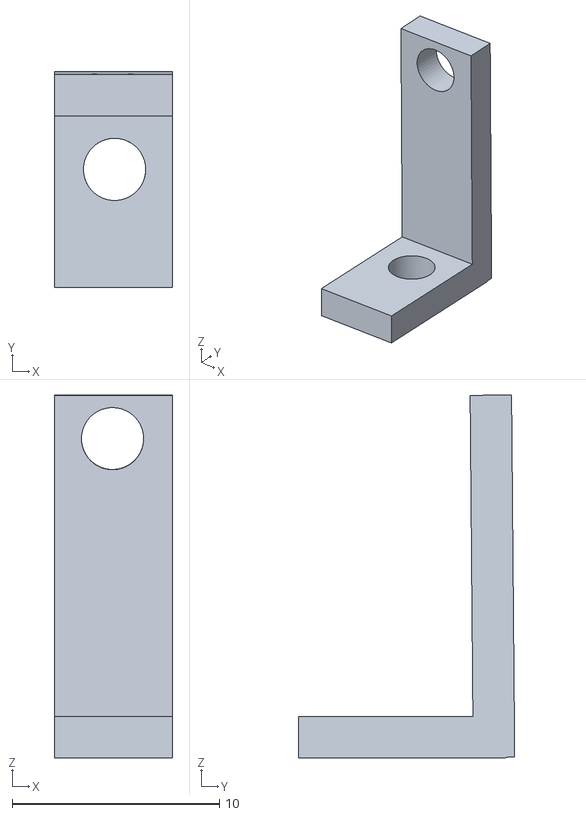
[picture p103: CAD file, 2026-06-14]
OtherFolders/3D_PrintFiles/ProjectA_3D_PrintFiles/hammer_handle_to_print.stl
5.70 x 10.4 x 17.5
