liyakeselman/Spinning_Top_Real_Time_Platform/OtherFolders/3D_PrintFiles/ProjectB_3D_PrintFiles/cone_buttom.step

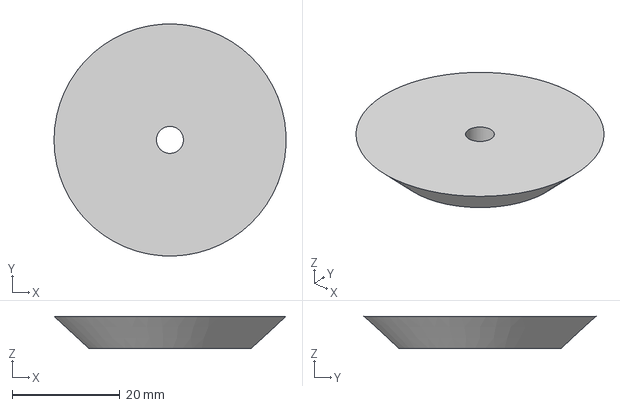
[picture p104: CAD file, 2026-06-14]
OtherFolders/3D_PrintFiles/ProjectB_3D_PrintFiles/cone_buttom.step
43.0 x 43.0 x 6.00 mm
