liyakeselman/Spinning_Top_Real_Time_Platform/OtherFolders/KiCad/KiCad_ProjB/geometry.dxf

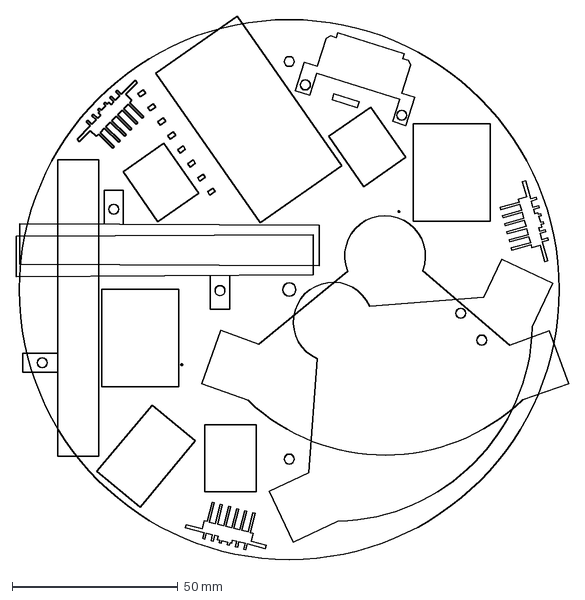
[picture p105: CAD file, 2026-06-14]
OtherFolders/KiCad/KiCad_ProjB/geometry.dxf
166.8 x 164.0 mm
