liyakeselman/Spinning_Top_Real_Time_Platform/OtherFolders/3D_Fusion360Files/ProjectA_3D_Fusion360Files/BatteryHolderFiles/lithium-ion-18650-battery-holder-1.snapshot.3/Battery-Holder_Metal-Lead.STEP

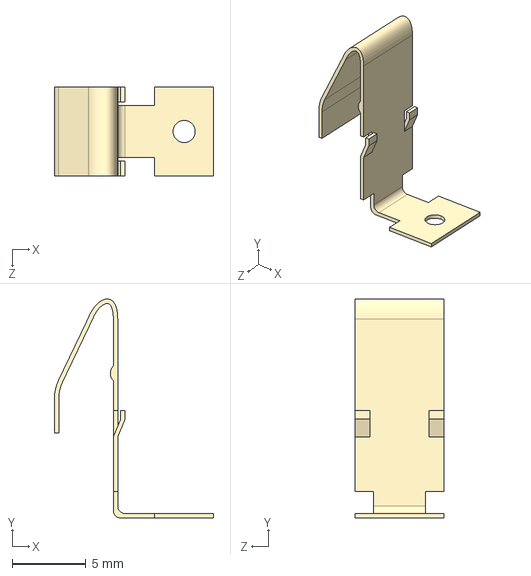
[picture p106: CAD file, 2026-06-14]
OtherFolders/3D_Fusion360Files/ProjectA_3D_Fusion360Files/BatteryHolderFiles/lithium-ion-18650-battery-holder-1.snapshot.3/Battery-Holder_Metal-Lead.STEP
10.8 x 14.8 x 6.00 mm
