liyakeselman/Spinning_Top_Real_Time_Platform/OtherFolders/3D_Fusion360Files/ProjectA_3D_Fusion360Files/GeometryFiles/geometry.dxf

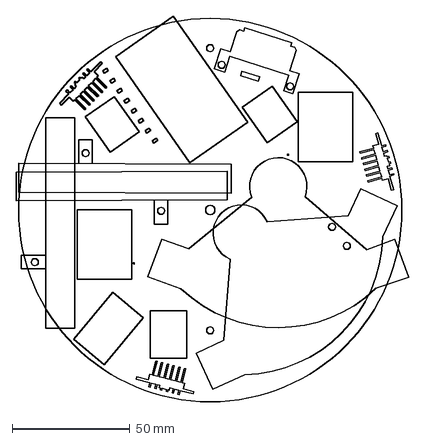
[picture p107: CAD file, 2026-06-14]
OtherFolders/3D_Fusion360Files/ProjectA_3D_Fusion360Files/GeometryFiles/geometry.dxf
166.8 x 164.0 mm
