liyakeselman/Spinning_Top_Real_Time_Platform/OtherFolders/3D_PrintFiles/ProjectA_3D_PrintFiles/comb_cone_to_other_groups.step

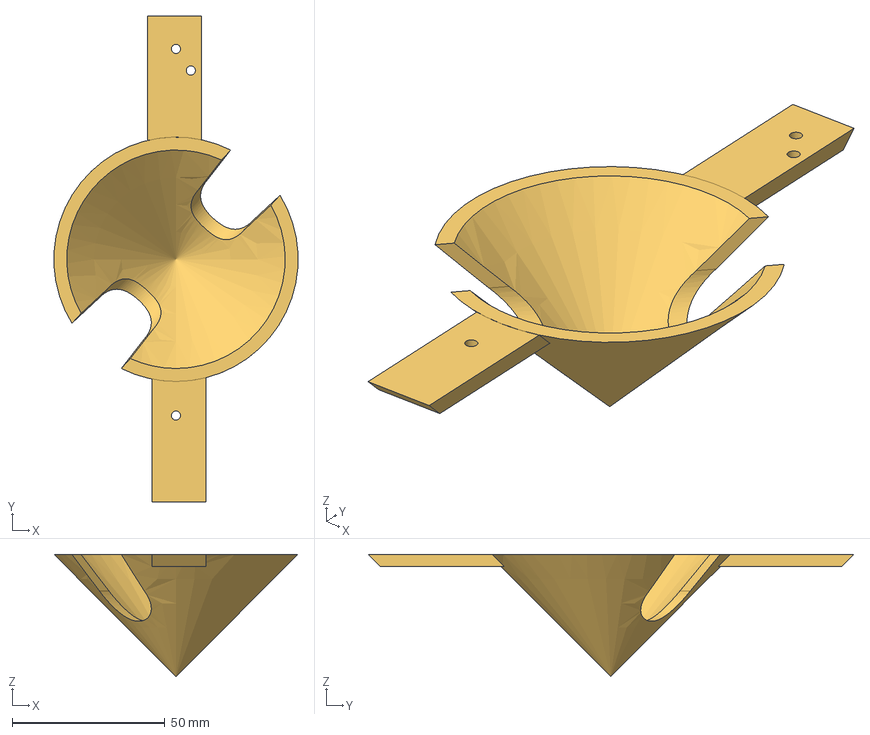
[picture p108: CAD file, 2026-06-14]
OtherFolders/3D_PrintFiles/ProjectA_3D_PrintFiles/comb_cone_to_other_groups.step
79.9 x 159.0 x 40.0 mm
