liyakeselman/Spinning_Top_Real_Time_Platform/OtherFolders/3D_PrintFiles/ProjectB_3D_PrintFiles/cone_shield.step

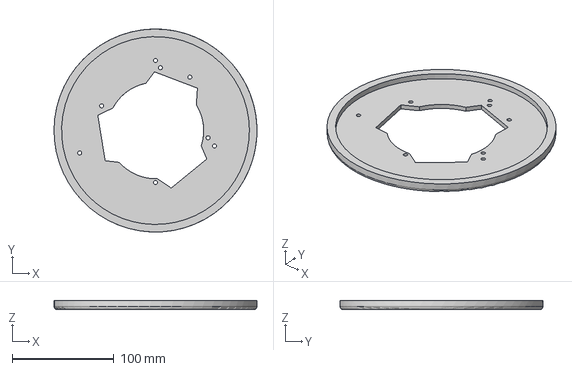
[picture p109: CAD file, 2026-06-14]
OtherFolders/3D_PrintFiles/ProjectB_3D_PrintFiles/cone_shield.step
200.0 x 199.9 x 9.00 mm
