liyakeselman/Spinning_Top_Real_Time_Platform/OtherFolders/3D_Fusion360Files/ProjectA_3D_Fusion360Files/VL53L0XV2Files/pin_header.SLDPRT

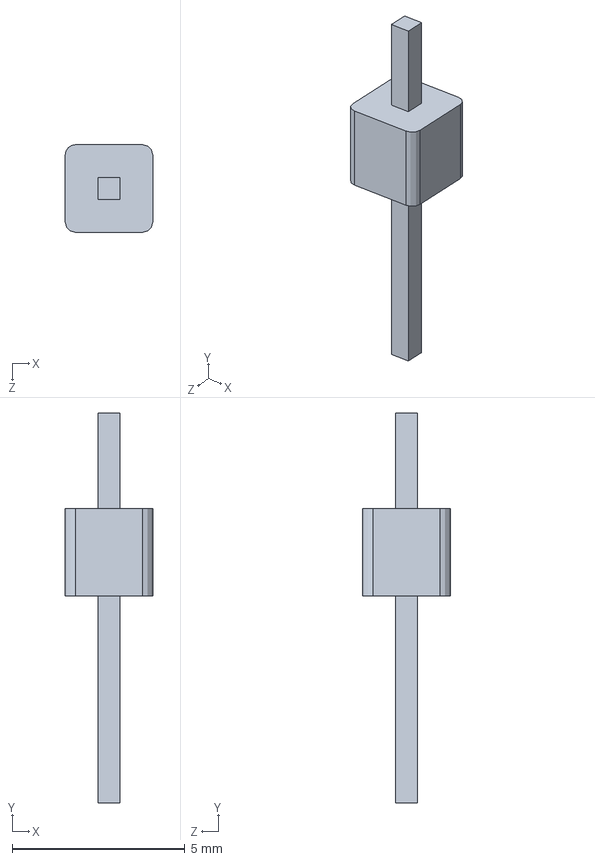
[picture p112: CAD file, 2026-06-14]
OtherFolders/3D_Fusion360Files/ProjectA_3D_Fusion360Files/VL53L0XV2Files/pin_header.SLDPRT
2.54 x 11.3 x 2.54 mm
