liyakeselman/Spinning_Top_Real_Time_Platform/OtherFolders/3D_PrintFiles/ProjectA_3D_PrintFiles/luna_handle_to_print.stl

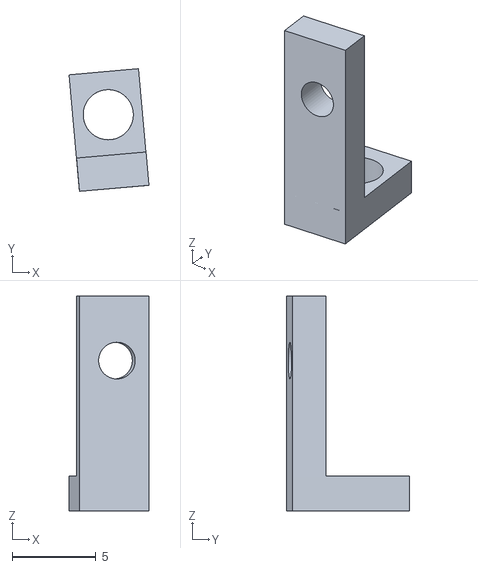
[picture p113: CAD file, 2026-06-14]
OtherFolders/3D_PrintFiles/ProjectA_3D_PrintFiles/luna_handle_to_print.stl
4.79 x 7.34 x 12.9
