liyakeselman/Spinning_Top_Real_Time_Platform/OtherFolders/3D_PrintFiles/ProjectB_3D_PrintFiles/tip15.step

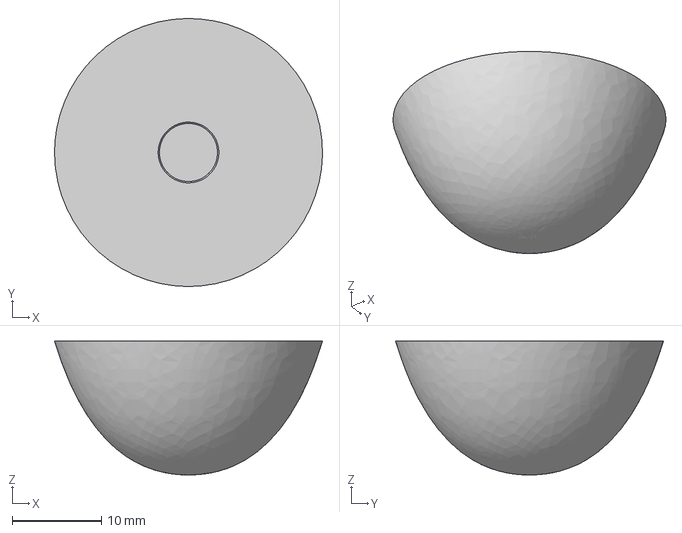
[picture p114: CAD file, 2026-06-14]
OtherFolders/3D_PrintFiles/ProjectB_3D_PrintFiles/tip15.step
30.0 x 30.0 x 15.0 mm
