liyakeselman/Spinning_Top_Real_Time_Platform/OtherFolders/3D_PrintFiles/ProjectB_3D_PrintFiles/mid_cone.step

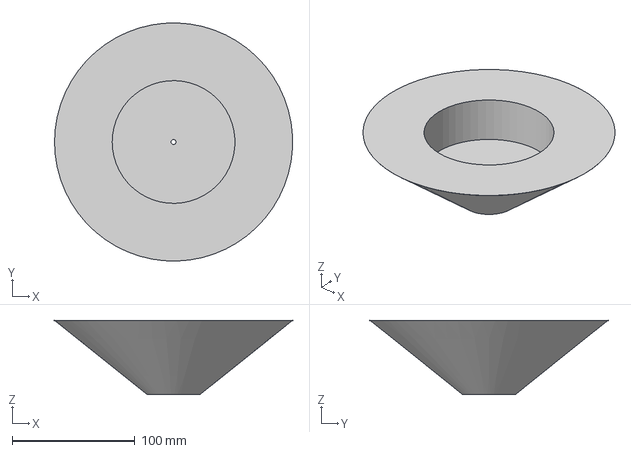
[picture p116: CAD file, 2026-06-14]
OtherFolders/3D_PrintFiles/ProjectB_3D_PrintFiles/mid_cone.step
193.9 x 193.9 x 60.4 mm
