liyakeselman/Spinning_Top_Real_Time_Platform/OtherFolders/3D_PrintFiles/ProjectA_3D_PrintFiles/hammer_v2.step

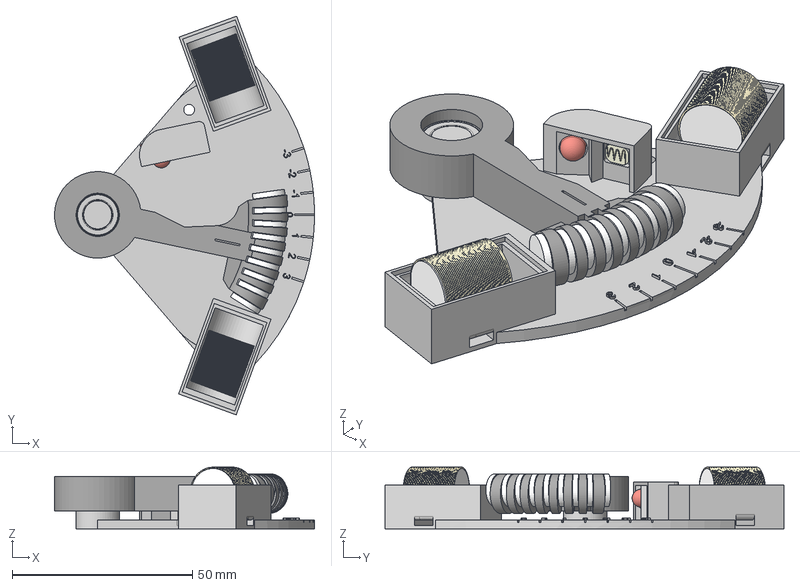
[picture p117: CAD file, 2026-06-14]
OtherFolders/3D_PrintFiles/ProjectA_3D_PrintFiles/hammer_v2.step
72.1 x 110.6 x 17.1 mm
Photoresistor
Left coil (1)
Right coil
Ball Bearing
22mm hammer (3)
