liyakeselman/Spinning_Top_Real_Time_Platform/(list of files, cad)

Other CAD files:
OtherFolders/3D_Fusion360Files/ProjectA_3D_Fusion360Files/TP4056Files/tp4056_pcb_asm v1.step
OtherFolders/3D_Fusion360Files/ProjectA_3D_Fusion360Files/FullModelFiles/model_v8.obj
OtherFolders/3D_Fusion360Files/ProjectA_3D_Fusion360Files/VL53L0XV2Files/vl53l0x no headers.STEP
OtherFolders/3D_PrintFiles/ProjectA_3D_PrintFiles/additionalFiles/hammer_v2.obj
OtherFolders/3D_PrintFiles/ProjectA_3D_PrintFiles/additionalFiles/model_v8.obj
OtherFolders/3D_PrintFiles/ProjectA_3D_PrintFiles/cone_to_print.stl
OtherFolders/3D_Fusion360Files/ProjectA_3D_Fusion360Files/BatteryFiles/Battery.f3d
OtherFolders/3D_Fusion360Files/ProjectA_3D_Fusion360Files/BatteryHolderFiles/lithium-ion-18650-battery-holder-1.snapshot.3/Assem1.SLDASM
OtherFolders/3D_Fusion360Files/ProjectA_3D_Fusion360Files/BatteryHolderFiles/lithium-ion-18650-battery-holder-1.snapshot.3/Battery Holder.SLDPRT
OtherFolders/3D_Fusion360Files/ProjectA_3D_Fusion360Files/BatteryHolderFiles/lithium-ion-18650-battery-holder-1.snapshot.3/Battery-Holder_Metal-Lead.SLDPRT
OtherFolders/3D_Fusion360Files/ProjectA_3D_Fusion360Files/DreidelFiles/part1/dreidel_prototype.f3d
OtherFolders/3D_Fusion360Files/ProjectA_3D_Fusion360Files/DreidelFiles/part2/Battery.f3d
OtherFolders/3D_Fusion360Files/ProjectA_3D_Fusion360Files/DreidelFiles/part2/handle.f3d
OtherFolders/3D_Fusion360Files/ProjectA_3D_Fusion360Files/DreidelFiles/part2/pcb.f3d
OtherFolders/3D_Fusion360Files/ProjectA_3D_Fusion360Files/ESP32Files/option5_ESp32-WROOM-32U v3.f3d
OtherFolders/3D_Fusion360Files/ProjectA_3D_Fusion360Files/ScrewsFiles/m4_10cm.f3d
OtherFolders/3D_Fusion360Files/ProjectA_3D_Fusion360Files/TFLunaFiles/benewake-tf-luna-8m-low-cost-distance-sensor-1.snapshot.1/Sensor LUNA.SLDPRT
OtherFolders/3D_Fusion360Files/ProjectA_3D_Fusion360Files/TFLunaFiles/benewake-tf-luna-8m-low-cost-distance-sensor-1.snapshot.1/Sensor LUNA.STL
OtherFolders/3D_Fusion360Files/ProjectA_3D_Fusion360Files/TFLunaFiles/benewake-tf-luna-8m-low-cost-distance-sensor-1.snapshot.1/Sensor LUNA.x_t
OtherFolders/3D_Fusion360Files/ProjectA_3D_Fusion360Files/VL53L0XV2Files/vl53l0x.SLDASM
