liyakeselman/Spinning_Top_Real_Time_Platform/OtherFolders/3D_PrintFiles/ProjectA_3D_PrintFiles/Readme.txt

ProjectA_3D_PrintFiles Directory Content:
comb_cone_to_other_groups.step  
cone_to_print.stl  
hammer_v2.step  
hammer_handle_to_print.stl  
hammer_to_print.stl  
luna_handle_to_print.stl  
(directory) additionalFiles
