liyakeselman/Spinning_Top_Real_Time_Platform/OtherFolders/3D_PrintFiles/ProjectB_3D_PrintFiles/Readme.txt

ProjectB_3D_PrintFiles Directory Content:
cone_buttom.step
cone_shield.step
tip15.step

NOTE:
- RESIN PRINT: cone_buttom.step and cone_shield.step 
- BRASS PRINT: tip15.step
