liyakeselman/Spinning_Top_Real_Time_Platform/OtherFolders/3D_PrintFiles/Readme.txt

3D_PrintFiles Directory Content:
(directory) ProjectA_3D_PrintFiles
(directory) ProjectB_3D_PrintFiles
