liyakeselman/Spinning_Top_Real_Time_Platform/Pres/OnlinePres/Characterization_Presentation.txt

Link to Characterization Presentation:
https://prezi.com/view/jjVwO6FMcwyOWMPIOQS2/?referral_token=GLuTjVlnB3FN
