liyakeselman/Spinning_Top_Real_Time_Platform/Sch/Schematic.pdf

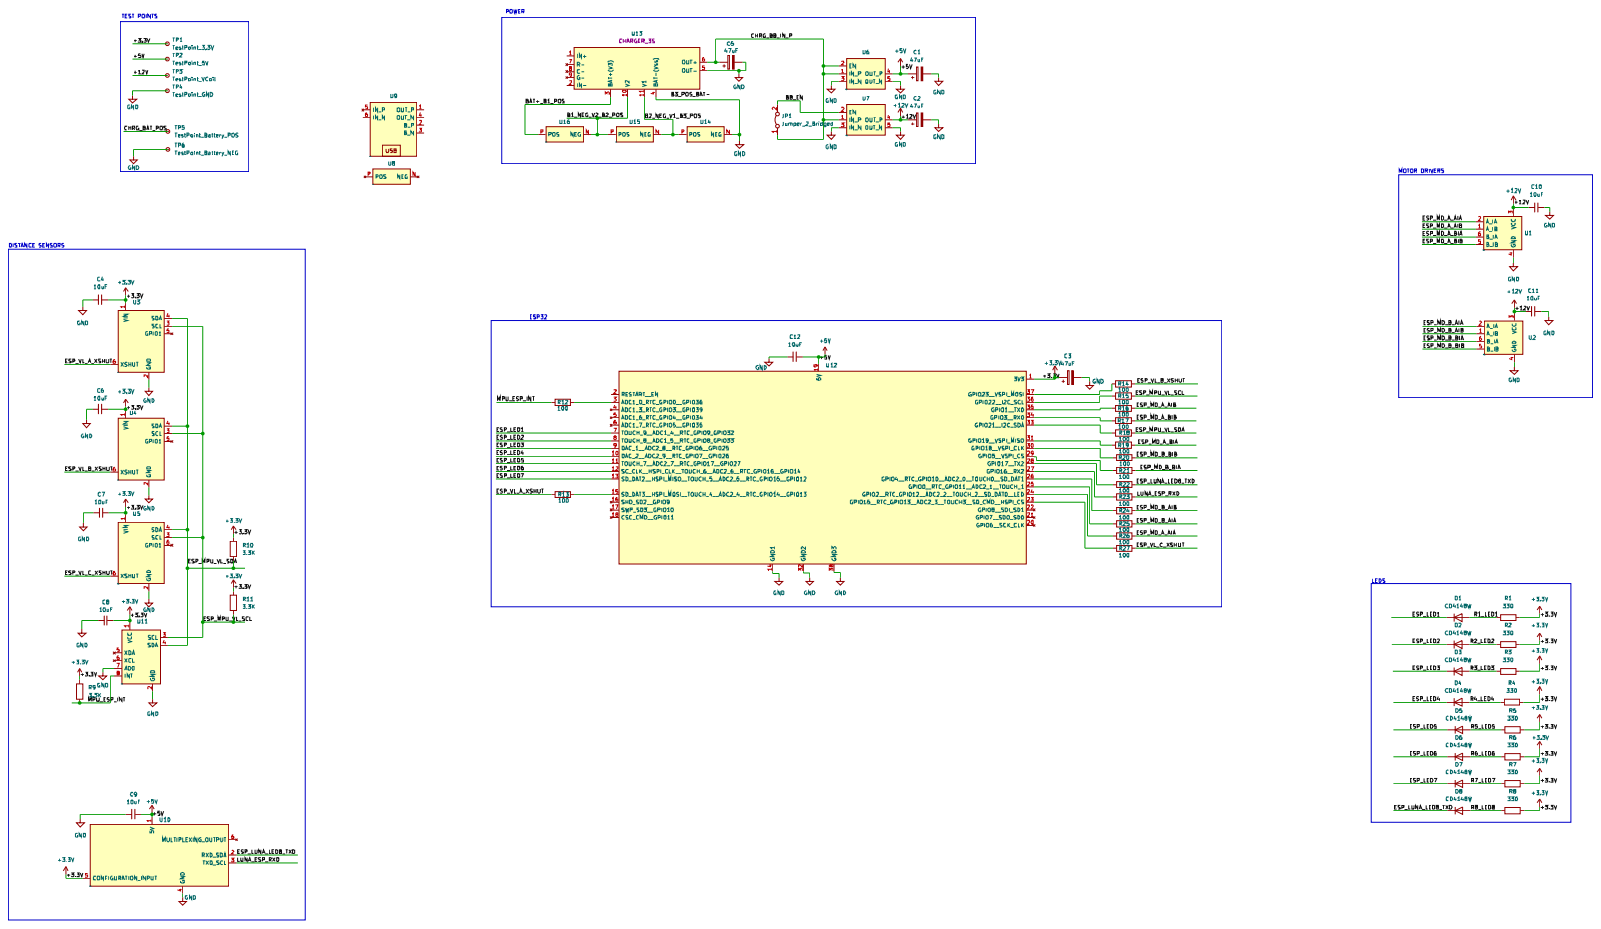
[picture p121: page 1]
