liyakeselman/Spinning_Top_Real_Time_Platform/OtherFolders/KiCad/KiCad_ProjA/projectA/schematic/schematic_pdf.pdf

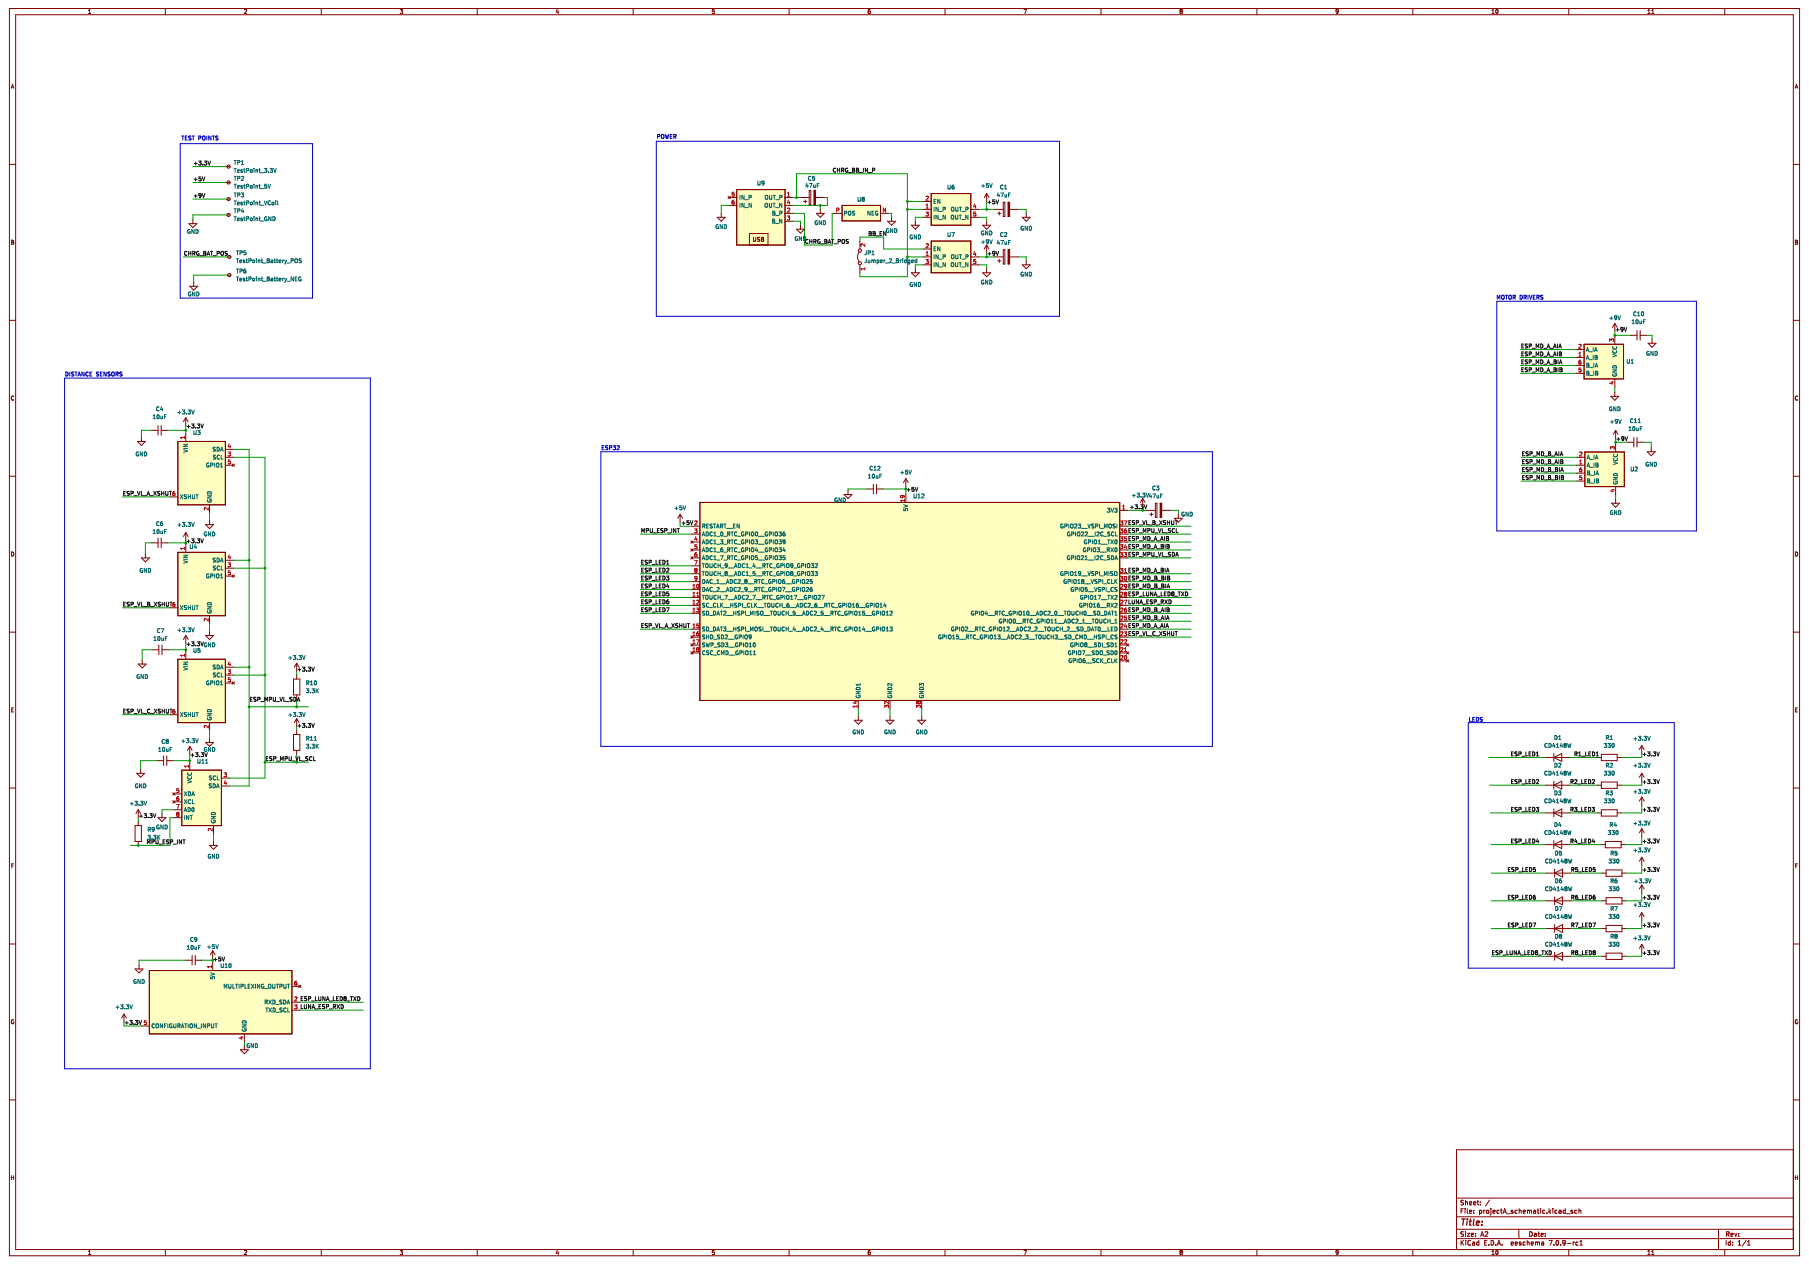
[picture p122: page 1]
