liyakeselman/Spinning_Top_Real_Time_Platform/OtherFolders/KiCad/KiCad_ProjA/projectA/schemes/schematic.pdf

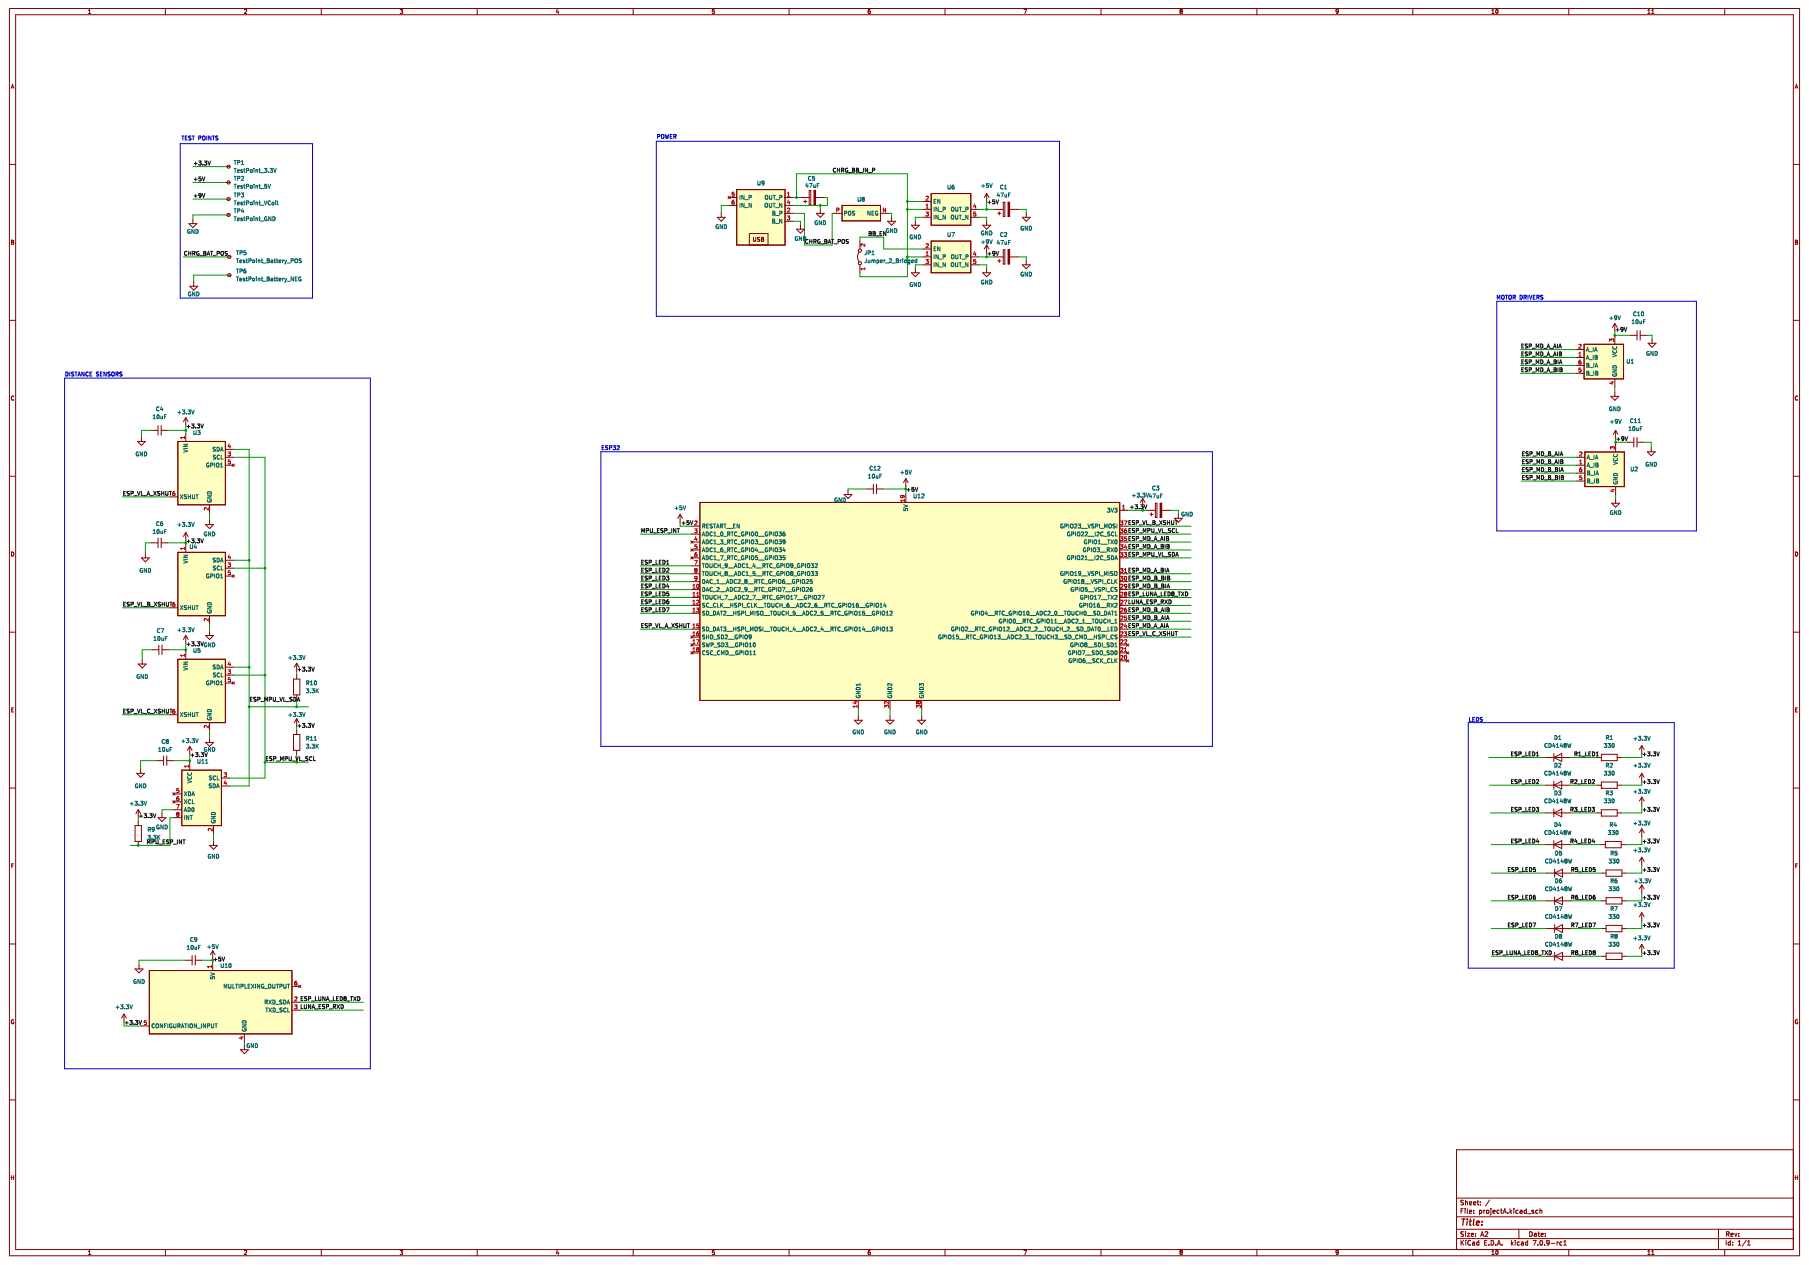
[picture p123: page 1]
