liyakeselman/Spinning_Top_Real_Time_Platform/Sch/CompositionScheme.pdf

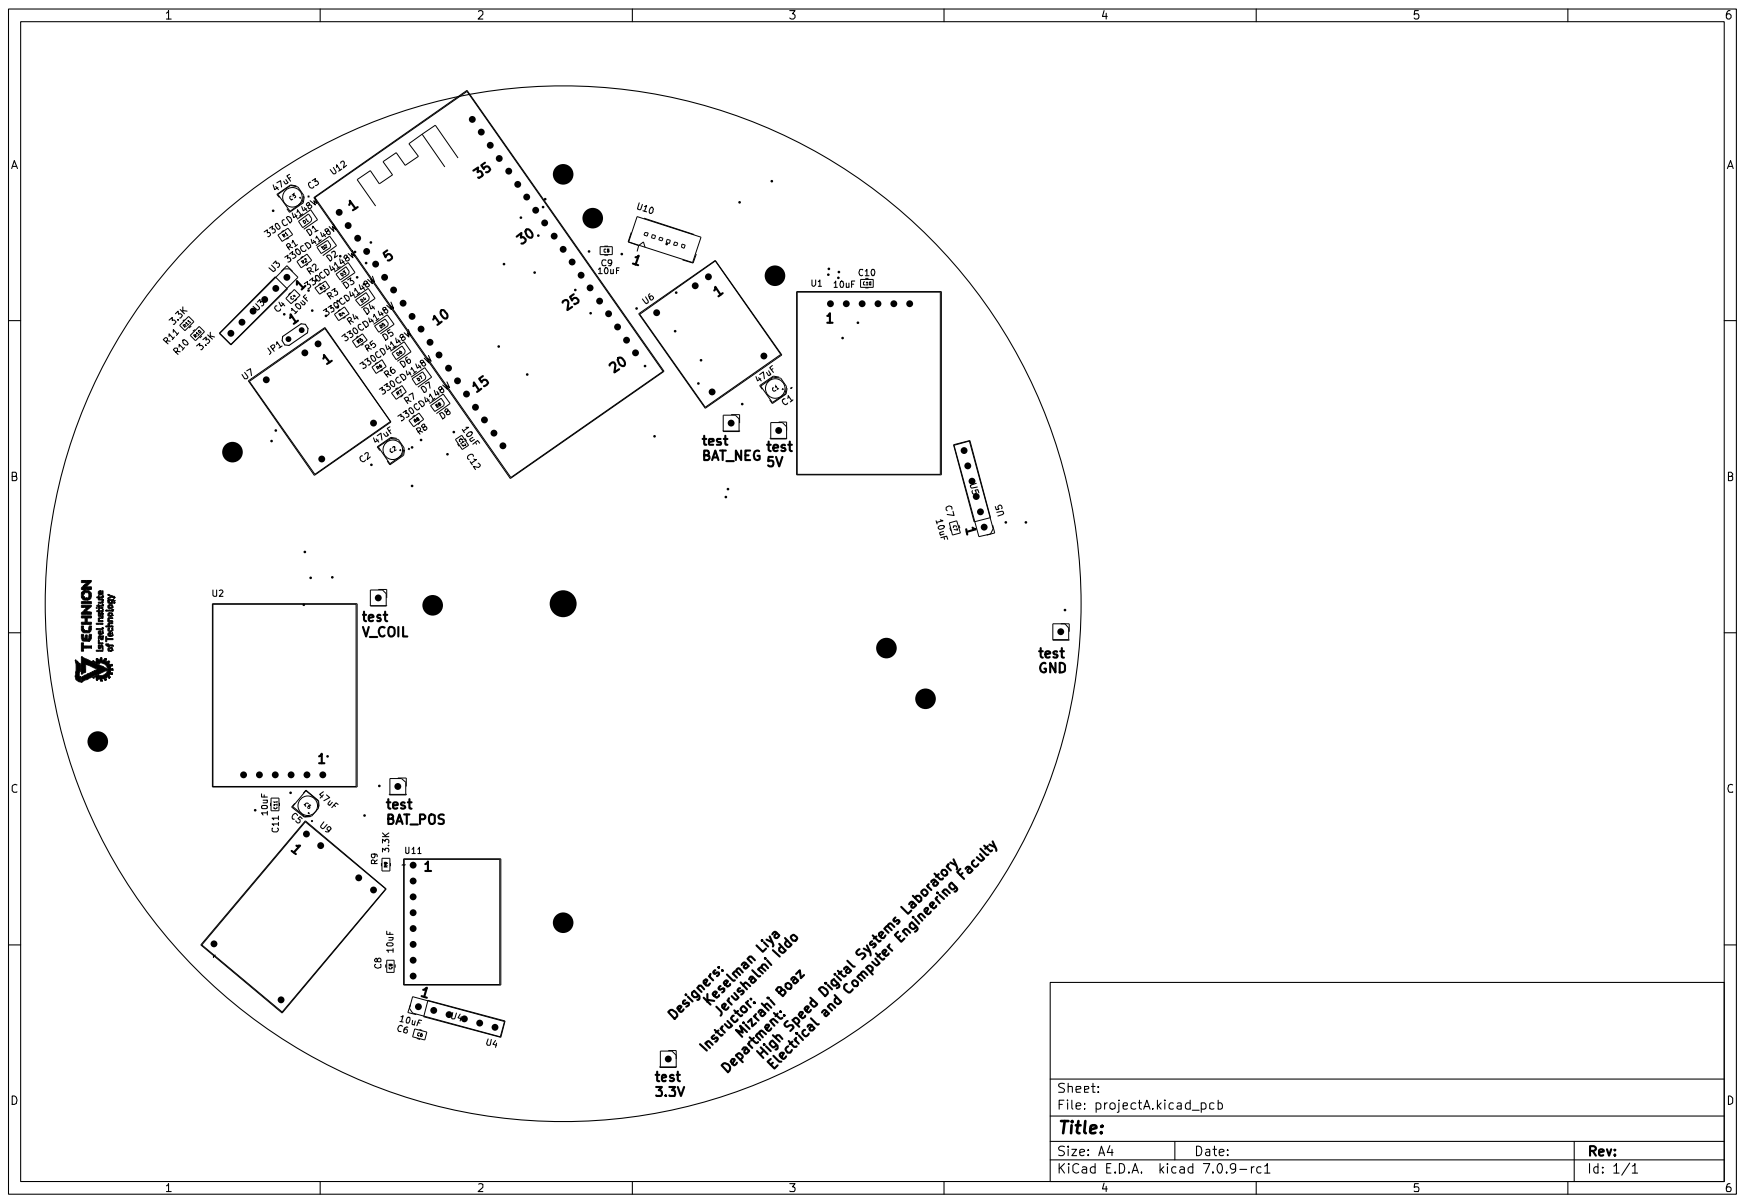
[picture p124: page 1]
