liyakeselman/Spinning_Top_Real_Time_Platform/OtherFolders/KiCad/KiCad_ProjA/projectA/kicad2026_prep.kicad_pcb

## KiCad design OtherFolders/KiCad/KiCad_ProjA/projectA/kicad2026_prep.kicad_pcb (2026-06-14)

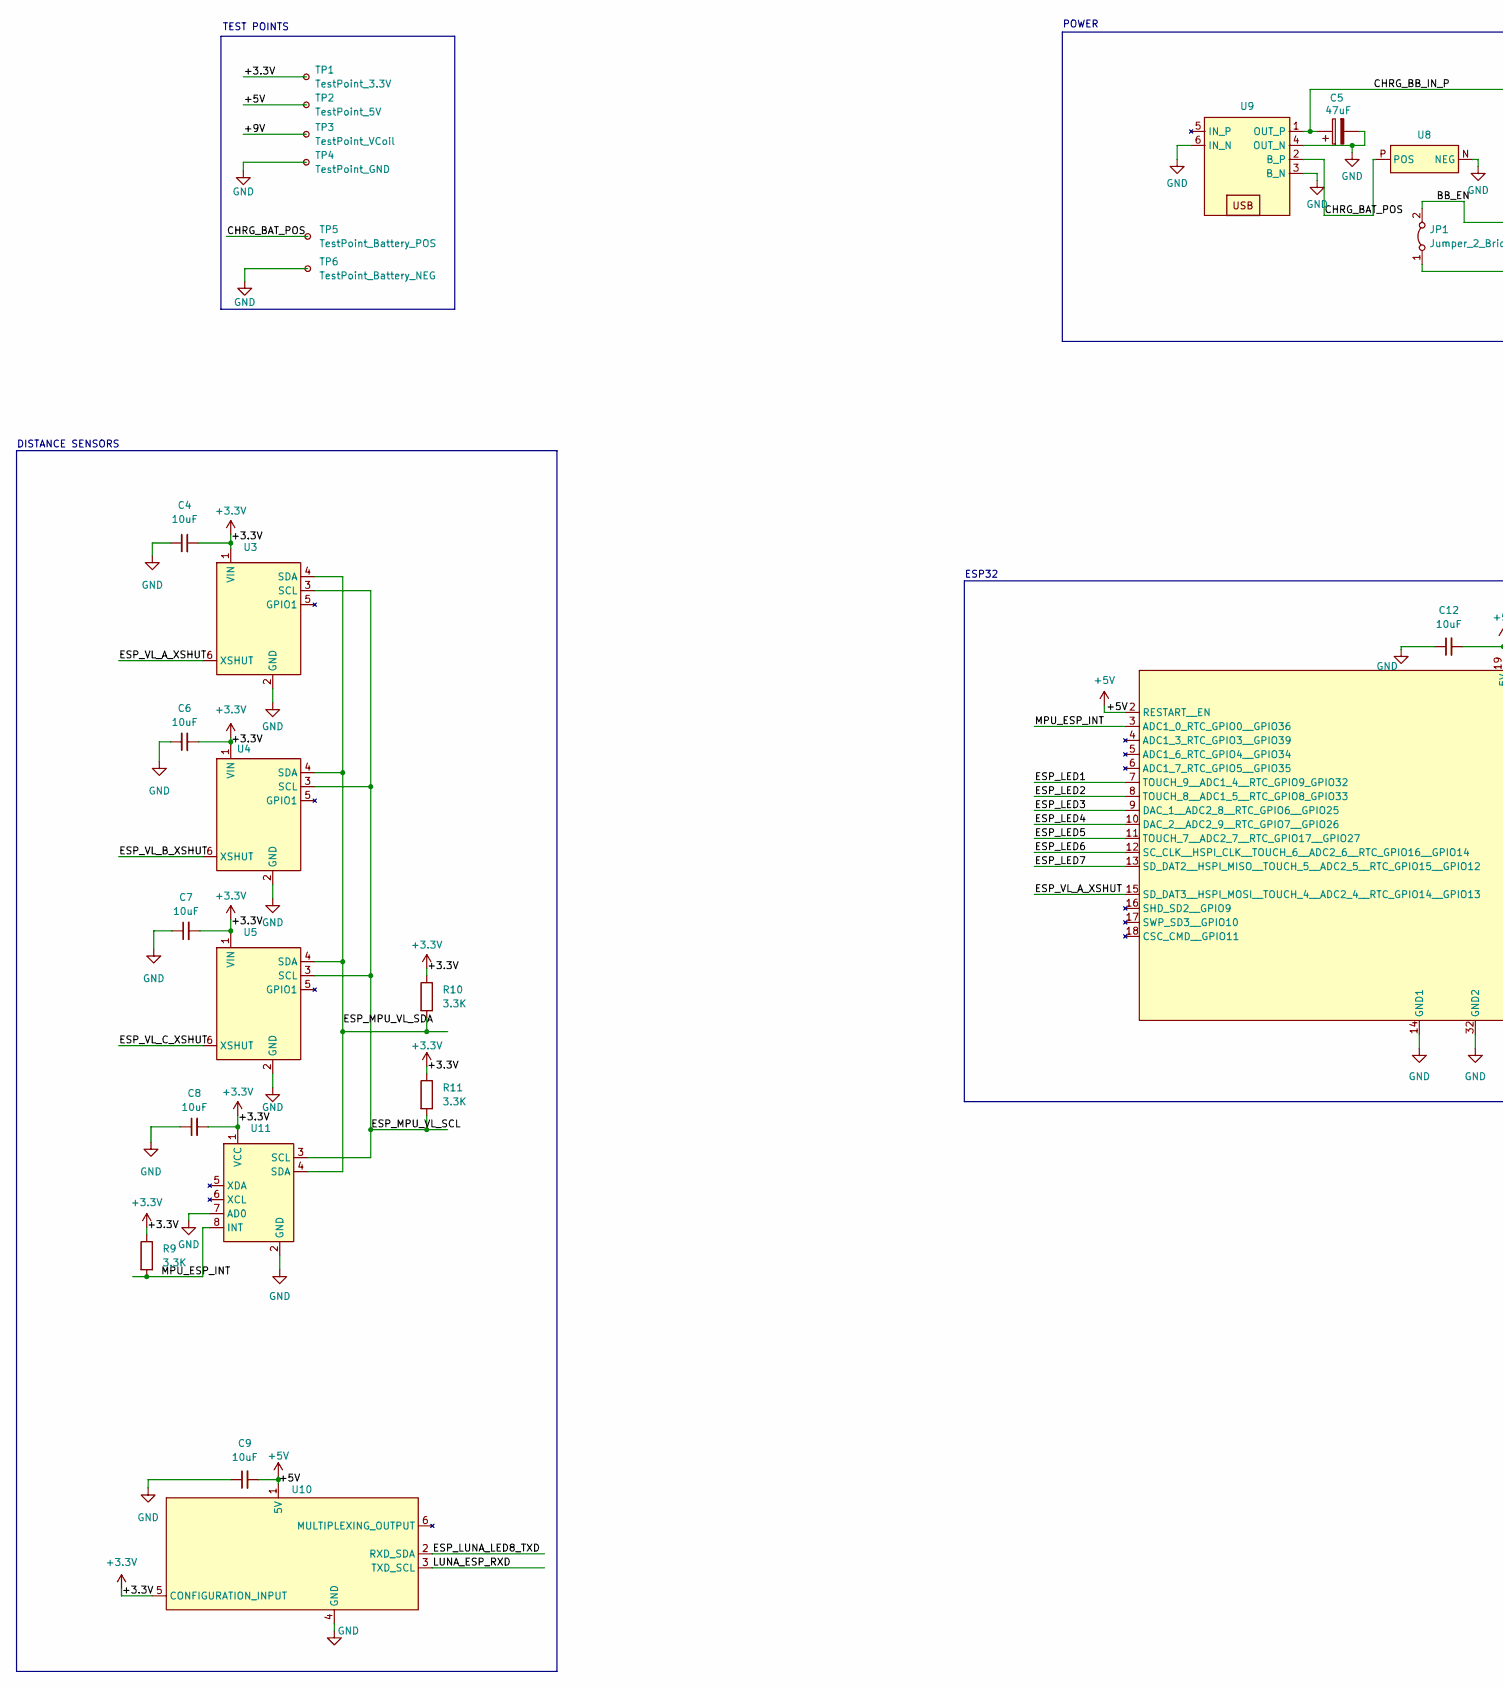
[picture p125: schematic kicad2026_prep.kicad_sch, part in row 1, column 1]

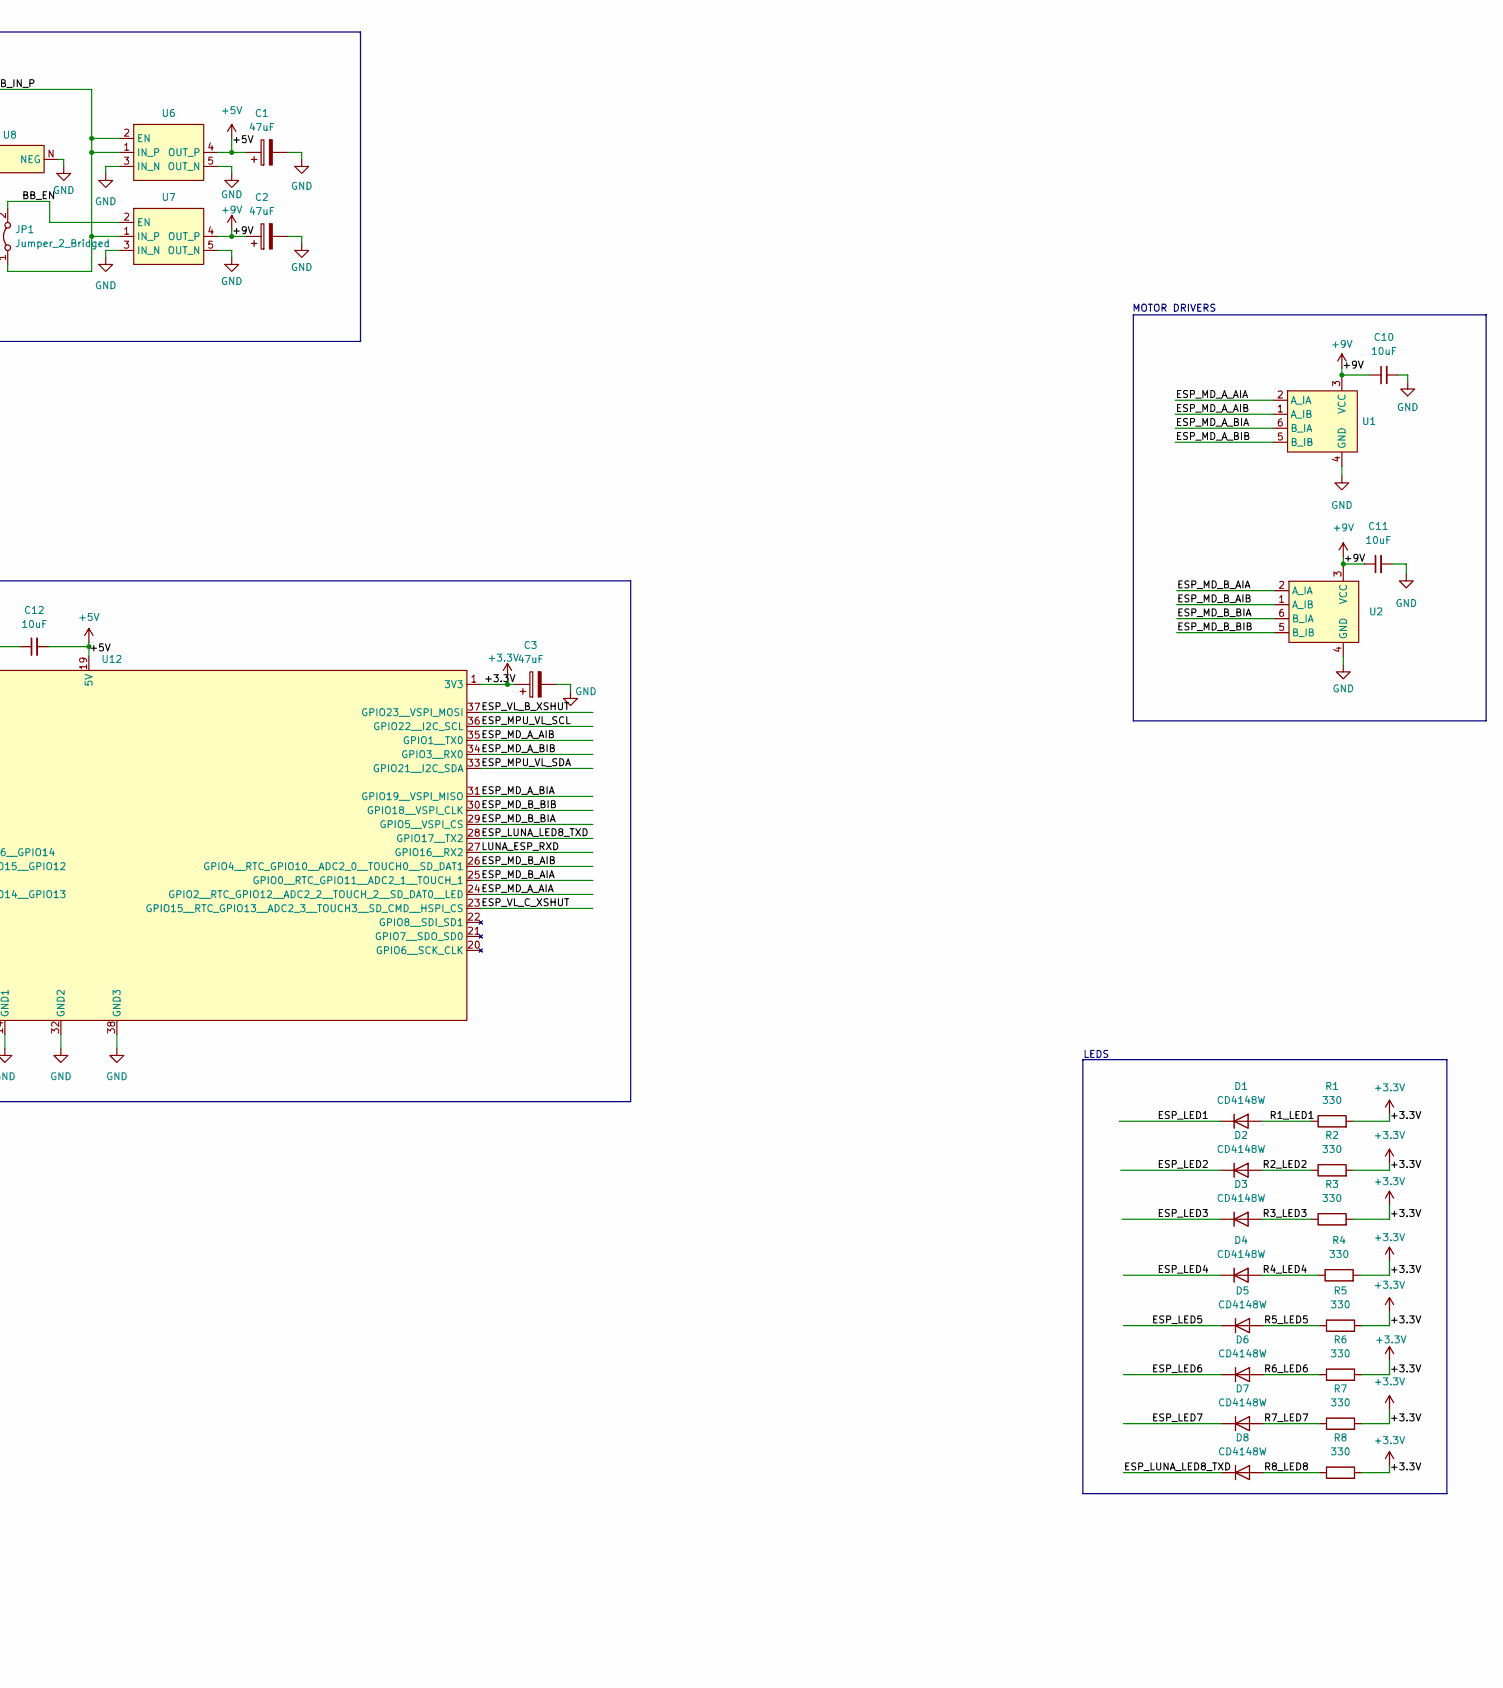
[picture p126: schematic kicad2026_prep.kicad_sch, part in row 1, column 2]

Parts:
C1, C2, C3, C5: 47uF; CP_Elec_3x5.3
C4, C6, C7, C8, C9, C10, C11, C12: 10uF; C_0805_2012Metric
D1, D2, D3, D4, D5, D6, D7, D8: CD4148W; D_0805_2012Metric
JP1: Jumper_2_Bridged; TestPoint_2Pads_Pitch2.54mm_Drill0.8mm
R1, R2, R3, R4, R5, R6, R7, R8: 330; R_0805_2012Metric
R9, R10, R11: 3.3K; R_0805_2012Metric
TP1: TestPoint_3.3V; PinSocket_1x01_P2.54mm_Vertical
TP2: TestPoint_5V; PinSocket_1x01_P2.54mm_Vertical
TP3: TestPoint_VCoil; PinSocket_1x01_P2.54mm_Vertical
TP4: TestPoint_GND; PinSocket_1x01_P2.54mm_Vertical
TP5: TestPoint_Battery_POS; PinSocket_1x01_P2.54mm_Vertical
TP6: TestPoint_Battery_NEG; PinSocket_1x01_P2.54mm_Vertical
U1, U2: MOTOR_DRIVER
U3, U4, U5: VL53L0XV2
U6, U7: BUCK_BOOST
U8: BATTERY_HOLDER
U9: CHARGE_CONTROLLER
U10: TF_LUNA
U11: MPU6050
U12: ESP32

Connections:
+3.3V: C3.1, C4.2, C6.2, C7.2, C8.2, R1.2, R2.2, R3.2, R4.2, R5.2, R6.2, R7.2, R8.2, R9.1, R10.1, R11.1, TP1.1, U3.1 (VIN), U4.1 (VIN), U5.1 (VIN), U10.5 (CONFIGURATION_INPUT), U11.1 (VCC), U12.1 (3V3)
+5V: C1.1, C9.2, C12.2, TP2.1, U6.4 (OUT_P), U10.1 (5V), U12.2 (RESTART__EN), U12.19 (5V)
+9V: C2.1, C10.1, C11.1, TP3.1, U1.3 (VCC), U2.3 (VCC), U7.4 (OUT_P)
/BB_EN: JP1.2 (B), U7.2 (EN)
/CHRG_BAT_POS: TP5.1, U8.P (POS), U9.2 (B_P); also elsewhere on the board
/CHRG_BB_IN_P: C5.1, JP1.1 (A), U6.1 (IN_P), U6.2 (EN), U7.1 (IN_P), U9.1 (OUT_P)
/ESP_LED1: D1.1 (K), U12.7 (TOUCH_9__ADC1_4__RTC_GPIO9_GPIO32)
/ESP_LED2: D2.1 (K), U12.8 (TOUCH_8__ADC1_5__RTC_GPIO8_GPIO33)
/ESP_LED3: D3.1 (K), U12.9 (DAC_1__ADC2_8__RTC_GPIO6__GPIO25)
/ESP_LED4: D4.1 (K), U12.10 (DAC_2__ADC2_9__RTC_GPIO7__GPIO26)
/ESP_LED5: D5.1 (K), U12.11 (TOUCH_7__ADC2_7__RTC_GPIO17__GPIO27)
/ESP_LED6: D6.1 (K), U12.12 (SC_CLK__HSPI_CLK__TOUCH_6__ADC2_6__RTC_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)
/ESP_LED7: D7.1 (K), U12.13 (SD_DAT2__HSPI_MISO__TOUCH_5__ADC2_5__RT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)
/ESP_LUNA_LED8_TXD: D8.1 (K), U10.2 (RXD_SDA), U12.28 (GPIO17__TX2)
/ESP_MD_A_AIA: U1.2 (A_IA), U12.24 (GPIO2__RTC_GPIO12__ADC2_2__TOUCH_2__SD_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)
/ESP_MD_A_AIB: U1.1 (A_IB), U12.35 (GPIO1__TX0)
/ESP_MD_A_BIA: U1.6 (B_IA), U12.31 (GPIO19__VSPI_MISO)
/ESP_MD_A_BIB: U1.5 (B_IB), U12.34 (GPIO3__RX0)
/ESP_MD_B_AIA: U2.2 (A_IA), U12.25 (GPIO0__RTC_GPIO11__ADC2_1__TOUCH_1)
/ESP_MD_B_AIB: U2.1 (A_IB), U12.26 (GPIO4__RTC_GPIO10__ADC2_0__TOUCH0__SD_D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)
/ESP_MD_B_BIA: U2.6 (B_IA), U12.29 (GPIO5__VSPI_CS)
/ESP_MD_B_BIB: U2.5 (B_IB), U12.30 (GPIO18__VSPI_CLK)
/ESP_MPU_VL_SCL: R11.2, U3.3 (SCL), U4.3 (SCL), U5.3 (SCL), U11.3 (SCL), U12.36 (GPIO22__I2C_SCL)
/ESP_MPU_VL_SDA: R10.2, U3.4 (SDA), U4.4 (SDA), U5.4 (SDA), U11.4 (SDA), U12.33 (GPIO21__I2C_SDA)
/ESP_VL_A_XSHUT: U3.6 (XSHUT), U12.15 (SD_DAT3__HSPI_MOSI__TOUCH_4__ADC2_4__RT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)
/ESP_VL_B_XSHUT: U4.6 (XSHUT), U12.37 (GPIO23__VSPI_MOSI)
/ESP_VL_C_XSHUT: U5.6 (XSHUT), U12.23 (GPIO15__RTC_GPIO13__ADC2_3__TOUCH3__SD_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)
/LUNA_ESP_RXD: U10.3 (TXD_SCL), U12.27 (GPIO16__RX2)
/MPU_ESP_INT: R9.2, U11.8 (INT), U12.3 (ADC1_0_RTC_GPIO0__GPIO36)
/R1_LED1: D1.2 (A), R1.1
/R2_LED2: D2.2 (A), R2.1
/R3_LED3: D3.2 (A), R3.1
/R4_LED4: D4.2 (A), R4.1
/R5_LED5: D5.2 (A), R5.1
/R6_LED6: D6.2 (A), R6.1
/R7_LED7: D7.2 (A), R7.1
/R8_LED8: D8.2 (A), R8.1
GND: C1.2, C2.2, C3.2, C4.1, C5.2, C6.1, C7.1, C8.1, C9.1, C10.2, C11.2, C12.1, TP4.1, TP6.1, U1.4 (GND), U2.4 (GND), U3.2 (GND), U4.2 (GND), U5.2 (GND), U6.3 (IN_N), U6.5 (OUT_N), U7.3 (IN_N), U7.5 (OUT_N), U8.N (NEG), U9.3 (B_N), U9.4 (OUT_N), U9.6 (IN_N), U10.4 (GND), U11.2 (GND), U11.7 (AD0), U12.14 (GND1), U12.32 (GND2), U12.38 (GND3); also elsewhere on the board

Notes on the sheet:
TEST POINTS
MOTOR DRIVERS
POWER
ESP32
LEDS
DISTANCE SENSORS

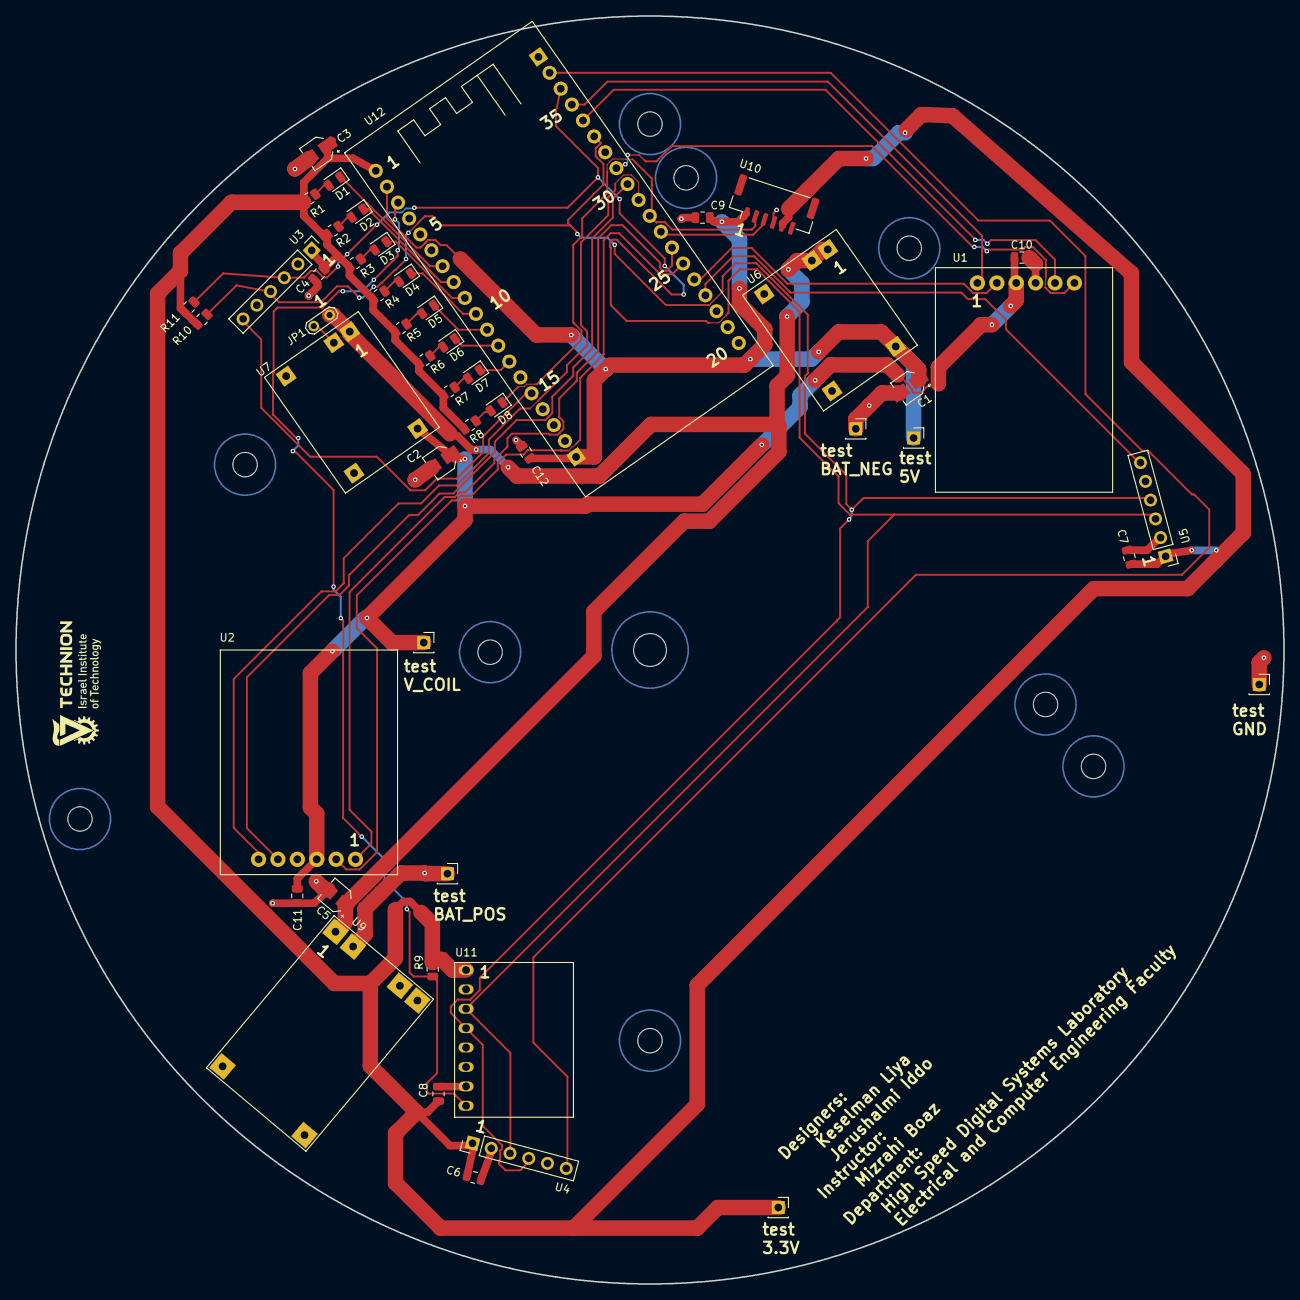
[picture p127: board kicad2026_prep.kicad_pcb from above]

Board: 2 copper layers, 166.0 x 166.0 mm, 50 parts (1 on the bottom side), 38 nets.

Other parts of the board:
8U: BATTERY_HOLDER

Their connections:
/CHRG_BAT_POS: 8U.P (POS); also elsewhere on the board
GND: 8U.N (NEG); also elsewhere on the board
